mitja1357/Seminar_iz_mehatronike/README.md

# Seminar_iz_mehatronike
Vse kar sem delal pri predmetu seminar iz mehatornike
