mitja1357/Seminar_iz_mehatronike/Porocilo/Alic_seminar_2017.pdf

## UNIVERZA V LJUBLJANI

FAKULTETA ZA ELEKTROTEHNIKO

POROCILO PRI PREDMETU SEMINAR IZ MEHATRONIKE ˇ

# DIGITALNI MERILNIK VRTILNE HITROSTI

## Mitja Aliˇc

Profesor:
prof. dr. Danijel Vonˇcina

Mentor:
doc. dr. Mitja Nemec

Ljubljana, 2017

Mitja Aliˇc | DIGITALNI MERILNIK VRTILNE HITROSTI

## Kazalo

1 Uvod | 2
2 Zahteve | 2
3 Sestava sheme | 3
4 Izdelava tiskanine | 5
5 Programiranje | 5
6 Pisanje poroˇcila | 8
7 Napake projekta | 8
8 Zakljuˇcek | 10
9 Dodatek 1 | 11
10 Dodatek 2 | 14

1

Mitja Aliˇc | DIGITALNI MERILNIK VRTILNE HITROSTI

## 1 Uvod

Pri predmetu seminar iz mehatronike sem si izbral projekt izdelave digitalneg merilnika vrtilne hitrosti. Pri delu na projektu, bom osvojil znanje risanje sheme oži-ˇcenja, risanja tiskanega vezja, izdelava vezja in testiranje. V povezavi s predmetom digitalno procesiranje v mehatroniki 2 (v nadaljevanju DP2), bom napisal program za doloˇcanje vrtilne hitrosti na podlagi poznavanja tenutnega kota zasuka. Cilj izdelanega vezja, je analogni prikaz vrtilne hitrosti na izhodu, katero bi lahko študentje opazovali na laboratorijskih vajah. Podobno seminarsko nalogo je imel Žiga Prajndl¹ leto prej, kjer je uporabil F28069 Piccolo controlSTICK. Piccolo se uporablja pri laboratorijskih vajah predmeta DP2. Na tem ˇcipu naj izdelal salgoritem, nato pa ga prenesel na svojo tiskanino, kjer bi uporabil drug mikrokrmilnik.

## 2 Zahteve

Na zaˇcetku sem si prebral poroˇcilo mojega predhodnika in njegove zahteve prilagodil. Osnovne zahteve so bile enake. Blokovna shema je na sliki 1. Tiskanina bo prikljuˇcena na 5 V napajalni vir. Ostale napetosti so generirane s DC-DC pretvornikom. Za znane komponente sem pregledal podatkovne liste in zaˇcel graditi shemo.

Slika 1: Blokovna shema merilnika z vrednostmi napajalnih napetosti in velikkostjo napetostnih siganlov

Za preraˇcunavanje in komunikacijo sem uporabil mikro krmilni TMS320F28027. Izvorno informacijo o kotu zasuka gredi elektromotorskega sklopa prejemamo iz absolutnega dajalnika zzasuka podjetja RLS z oznako RM44SI0012B30F2E10. Izhod senzorja je lahko inkremantalni z referenˇcno toˇcko, v obliki analognih potekov sinusa in kosinusa, ali preko serijske komunikacije. Komunikacija deluje v diferencialnem naˇcinu, kar poveˇca zanesljivost prenosa. Mikrokrmilnik podpira komunikacijo SPI, zato je potrebno uporabiti gonilik ki pretvori diferencialna signala v polariziran signal. Uporabil sem integrirano vezje SN65HVD73.
Na izhodni strani aplikacije želimo podatek o poziciji in poslediˇcno hitrosti našega pogona pošiljati naprej v analogni obliki za nadaljno regulacijo. Potrebna sta dva analogna izhoda zato sem uporabil TLV5618A. Gre za dvokanalni 12-bitni digitalno analogni pretvornik (DAC). Za višino referenˇcne napetosti Vref sem izbral napetost 4,096 V. Napetost sem generiral s LM4132BMF-4.1.
Tako komunikacija s senzorjem kot tudi z DAC-om zahteva SPI povezavo. Mikrokrmilnik ima le eno SPI enoto. Predhodnik je ugotovil, da lahko senzor in DAC poganja le z eno SPI enoto. Master-input slave-output (MISO) signal služi za prejemanje podatkov s senzorja. Master-output slave-input (MOSI) signal pošlje podatke na DAC. Uro komunikacijskega modula je povezana na obe enoti.

1Digitalni merilnik hitrosti, Žiga Prajndl, LRTME, Ljubljana, 2016

2

Mitja Aliˇc | DIGITALNI MERILNIK VRTILNE HITROSTI

Za zagotovitev željenih izhodnih napetosti izhoda DAC-a ojaˇcam s operacijskim ojaˇcevalnikom. Zahteva mentorja je bila , da ima operacijski ojaˇcevalnik ˇcim manjšo sofazno ojaˇcenje ter naj se vsi nahajajo v enem ohišju. Uporabil sem ojaˇcevaljnik OPA4192IPW. Potreboval sem bipolarno napajanje +/- 15 V, ki sem ga generiral s pretvornikom TMH515D.
Prisotnost napajanja prikazujem na rumeni LED diodi, prikljuˇceni na osnovno napajalno napetost 5 V. Z zeleno LED diodo sem prikazoval trenutno vrednost senzorja. S spreminjanjem pozicija se je spreminjala svetilnost LED diode. To sem izvedel s PWM enoto in tranzistorjem serijsko vezanega s LED diodo. Svetilnost LED diode je tako odvisna od preklopnega razmerja PWM enote. Enako sem storil za rdeˇco led diodo,ki je predstavljala absolutno vrednost hitrosti.

## 3 Sestava sheme

Shemo sem delal v programu Altium Designer 16.1. Celotna shema se nahaja v Dodatek 1.
Mentor mi je poslal svoje starejše projekte, po katerih sem nato povezal pine mikrokrmilnika (Slika 2). Ob njemu je postavljen JTAG konektor. GPIO in PWM pine sem po mikrokrmilniku razporedil tako, da so mi na tiskanini ˇcim bolje ustrezali.


Slika 2: Shema mikrokrmilnika

PWM pina sem povezal s tranzistorjema (Slika 3), kjer nisem povezal upora na maso ("pull-down"). Tako je na gate-u MOS-FET-a lahko ob nepriˇcakovanem dogodku (nedefiniran izhod PWM enote) ostal naboj in poslediˇcno je LED dioda svetila.
Pri povezavi pretvornika komunikacije je predhodnik naredil lapsus (zamenjal para ure in podatka na SN65HVD73). To sem zamenjal, nisem pa zamenjal tudi elemntov. Med izhodom senzorja zasuka mora biti paralelno vezan 120 Ω upor in manjši kondenzator. To pa sem obdržal med povezavama +CLK -CLK. Tekom projekta sem ugotovil, da je to napaka. Upor R10 in kondenzator C12 (Slika 4), bi se morala nahajati med +DAT in -DAT. Upora R11 in R12 bi morala biti na povezavi +CLK oz - CLK.

3

Mitja Aliˇc | DIGITALNI MERILNIK VRTILNE HITROSTI


Slika 3: Shema krmiljenja LED diod

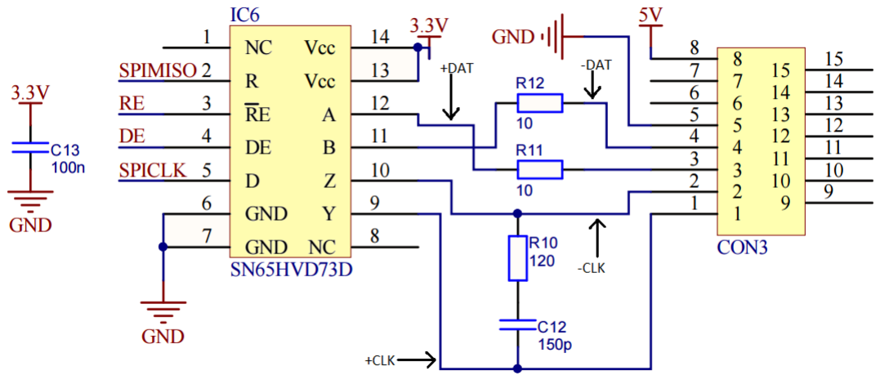
[picture p14: figure]

Slika 4: Shema komunikacije s senzorjem zasuka

Vezava DAC-a je na sliki 5. Takoj na sliki se vidi, da sem pine oznaˇceval na levi strani od zgoraj navzol in na desni prav tako. Ob izbiri "footprint-ašem upošteval razvršˇcenost pinov na levi od zgoraj navzol na desni pa od spodaj navzgor. Tako je bil "footprint"leve strani DAC-a v obratnem vrsnem redu. Huda napaka je predvsem to, da je masa DAC-a vezna na 5 V. Pini, vezani z ostalo periferijo lahko tako deformirajo druge dele vezja.


Slika 5: Shema DAC-a

Operacijske ojaˇcevalnike bi moral le prerisati, ojaˇcenje pa zmanjšati za polovico. Sam sem sestavil le blok kot skupek 4 ojaˇcevalnikov. Ob povezovanju sem naredil napako, da sem na ojaˇcevalniku C zamenjal vhoda. Tako sem naredil pozitivno po-

4

Mitja Aliˇc | DIGITALNI MERILNIK VRTILNE HITROSTI

vratno zanko in poslediˇcno vezje ni ustrezalo odštevalniku (Slika 6).


Slika 6: Shema operacijskega ojaˇcevalnika

## 4 Izdelava tiskanine

Ko sem shemo, po mojem mnenju zakljuˇcil, sem se lotil postavitve elementov na dvoplastno tiskanino. Rezultat je na sliki 7.
"Footprint-e" sem nastavil že na shemi, zato se s tem tu nisem ukvarjal. Vse napake na tiskanini, so posledica nenatanˇcnosti pri naˇcrtovanju sheme. Konektor za napajanje sem izbral tako, da je bilo potrebno vanj vijaˇciti napajalni žici. Naslednik naj uporabi konektor, katerega lahko izklopi brez kakšnih potrebnih pripomoˇckov. Sam sem postavil na tiskanino upore in kondenzatorje velikosti 0603²
. V laboratoriju
LRTME ponavadi uporabljajo komponente velikosti 0805, zato jih je bilo potrebno na Farnell-u naroˇciti. Najprej sem s pomoˇcjo Aleksandra Abramoviˇca naspajkal mikrokrmilnik, nato pa nadeljeval z upori ter kondenzatorji okoli mikrokrmilnika. Naspajkal sem vse razen napajalnika za napetost ±15V in DAC-a. DAC-a ob naroˇcanju materiala na Farnell-u ni bilo veˇc na zalogi, zato sem ga naroˇcil na Mouser-ju. Ko sem prviˇc priklopil vezje na napetostni vir, sem napajalno napetost poˇcasi višal in opazoval vhodni tok. Še preden sem zaˇcel vezje programirati sem prevezal pina na ojaˇcevalniku C, katera sem v shemi zamenjal. Preko Texas Instruments XDS100v2 USB Debug Probe sem priklopil vezje na raˇcunalnik in lahko zaˇcel programirati v Code Composer Studio.

## 5 Programiranje

Programirati sem zaˇcel v koncu februarja 2017. Projekt z zaˇcetnimi header datotekami, osnovnimi inicializacijami mikrokrmilnika in prekinitvijo mi je pripravil mentor. Potek programirannja sem si zadal po naslednjem seznamu:

2
Imperialne enote, v metriˇcnem sistemu je to 1608

5

Mitja Aliˇc | DIGITALNI MERILNIK VRTILNE HITROSTI

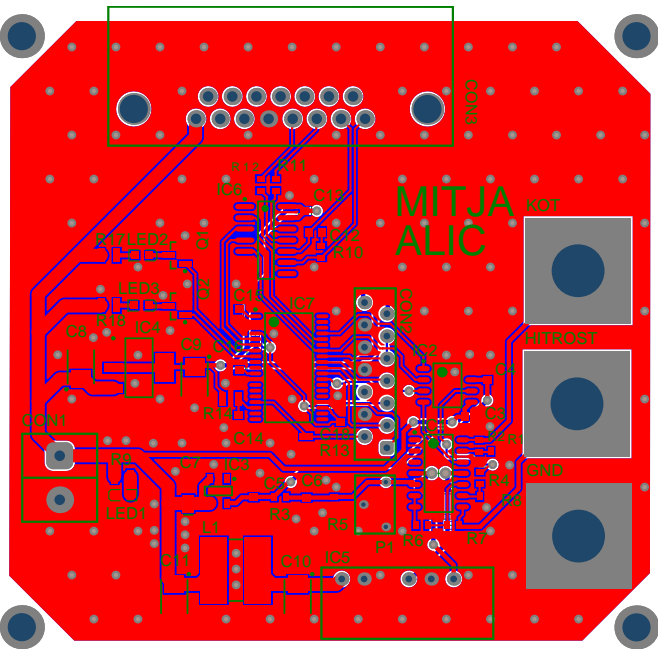
[picture p15: figure]
LED2; LED1; CON1; LED3; GND; HITROST; KOT; MITJA ALIC

Slika 7: Izgled tiskanine katera je šla v izdelavo

- Zaženi PWM enoto za krmiljenje LED diod
- Uredi komunikacijo s senzorjem zasuka
- Dodaj algoritem alfa beta filtra za izraˇcun hitrosti
- Uredi komunikacijo z DAC-om

### 5.1 PWM enota

Za PWM enoti sem moral pina GPIO 4 in GPIO 5 nastaviti za PWM izhoda. Nastavil sem registre tretjega modula PWM, kateremu pripadata izhodna pina. Ob reset-u programa sta prikazovalni LED diodi prikazovali nakljuˇcna stanja saj se je izhod PWM enote postavil v visoko impedanˇcno stanje, pull-down upora na gate-u tranzistorja pa ni bilo.

### 5.2 Povezava s senzorjem zasuka

Pri predmetu DP2 sem dobil že napisano inicializacijo in zajem kota po SPI komunikaciji. Potrebni datoteki (SPI_ dajalnik.h in SPI_ dajalnik.c) sem dodal v projekt. Nastaviti sem moral še pina za krmiljenje ˇcipa za spremembo komunikacije (DE na GPIO 2 in RE na GPIO 3). Nastavil sem ju na vrednosti tako, da je bila komunikacija ves ˇcas mogoˇca. Ko sem želel preveriti delovanje se je hitro pokazalo nedelovanje. Za vrnjen podatek sem dobil le invertiran urin signal. To je bila posledica moškega "footprint-a" konektorja za povezavo s senzorjem. Zaradi zrcaljne slike je bila žica

6

Mitja Aliˇc | DIGITALNI MERILNIK VRTILNE HITROSTI

katera napaja senzor vezana na pin CLK+. Senzor se je s tem signalom le prižigal in ugašal. To napako sem rešil tako, da sem konektor odstranil z zgornje strani tiskanine in ga prispajkal na spodnjo stran. S tem posegom sem izhodne pine konektorja spravil na pravo mesto in komunikacija je delovala.

### 5.3 Algoritem za izraˇcun hitrosti

Kodo za izraˇcun vrtilne hitrosti sem napisal že pri vajah predmeta DP2. Vrnjen rezultat je bila frekvenca in ne vrtilna hitrost, ki je le za faktor 2π skalirana. V programu sem raˇcunal s plavajoˇco vejico (na procesorju TMS320f28069). Ko sem dodal to kodo v moj mikrokrmilnik, se kode ni uspela izvajati dovolj hitro. Alogritem sem zato pretvoril na raˇcunaje s fiksno vejico³
. Algoritem se nahaja v Dodatek 2. Uporabil sem knjižnico IQ_ math. Algoritem se tako izvede v dovolj kratkem ˇcasu, ˇcasa pa nisem pomeril.

### 5.4 Povezava z digitalno analognim pretvornikom

Ko sem dobil DAC in je bil algoritem za izraˇcun hitrosti dokonˇcan, sem naspajkal pretvornik na tiskanino. Ob prikljuˇcitvi na napetostni vir, tiskanina ni izkazovala nobene napake. Zato sem se lotil nastavljanja izhodov za postavitev komunikacije. Za vzpostavitev komunikacije (chip enable), sem uporabil GPIO 34, kateri ima le to funkcijo. V "datasheet-u" nikjer drugje ni bil niˇc opisan. Vsi ostali pini imajo veˇc funkcij, zato je bil vsak pin podrobneje opisan, GPIO 34 pa ima le to funkcijo in ne potrebuje drugega opisa. Ko bi moral postaviti GPIO 34 na 0 V je imel ta konstntno 5 V. Naj omenim, da je mikrokrmilnik napajan s 3,3 V in v razponu, od 0 V do napajalne napetosti, je lahko izhod. To se mi tu še ni posvetilo. Dvomil sem v pin GPIO 34 kateri ni bil podrobneje opisan v "datasheet-u". Zato sem na mikrokrmilniku prevezal tako, da sem chip enable pin DAC-a povezal z GPIO 19. Ta pin ima že funkicjijo, da se postavi v želejeno stanje ob zaˇcetku SPI komuniciranja. Vendar ta prevezava ni pomagala. Mentor je nato ugotovil napako, ki je bila ustvarjena v shemi, da so pini DAC-a na levi strani zamenjani. Na tej toˇcki je mentor predlagal, da s projektom konˇcam in bo zapisan kot neuspešno izdelan. Nato sva ugotovila, da se lahko DAC še preveže v delujoˇce stanje.
Prevezal sem DAC in zaˇcelo je delovati. Po tem je bilo potrebno samo še skalirati in nastaviti vrednosti, da bo konˇcni izhod napetosti hitrosti in kota med ± 10V. Pojavila se je težava, da je izhod B DAC-a upadel za približno 1 V ko je potekala komunikacija. Tega nisem znal rešiti, slutim pa, da je bila napaka povzroˇcena z dodatnimi prevezavami na tiskanini.

### 5.5 Ostale težave

Nepravilno se je zaˇcel obnašati tudi komunikacija s senzorjem zasuka. Kljub temu, da je senzor prejemal urin signal, ni vraˇcal podatka. Podatek je vrnil ˇce sem ob pravem trenutku spremenil vednost DE pina na komunikaciji iz 0 na 1. To sem ugotovil, ko sem ponesreˇci povezal pin DE s pinom SPICLK. Vrednost na pinu DE je tako prekapljala med 0 in 1 in komunikacija je nato zaˇcela delovati. To sem poskušal nato doseˇci tudi s programom, tako da je preklapljal vrednost na pinu DE vendar se ni odzval vedno.

3Uporabil sem format f8.24

7

Mitja Aliˇc | DIGITALNI MERILNIK VRTILNE HITROSTI


Slika 8: Tiskanina na koncu projekta

Po tednu iskanja rešitve za nastale težave sem se odloˇcil in mentorju sporoˇcil, da bi projekt raje zakljuˇcil saj traja že predolgo. Projekt ni bil tako kompleksen, vendar sem si ga z napakami zakompliciral sam.

## 6 Pisanje poroˇcila

V poroˇcilu sem morala zbrati vse napake, ki sem jih naredil pri projektu. Hotel sem posneti oscilograme vendar sem ob tem skuril mikrokrmilnik. Zato oscilogramov v tem poroˇcilu ne boste opazili.

## 7 Napake projekta

### 7.1 Moški "footprint" za ženski konektor

Mentor me je velikokrat opozoril ali sem resniˇcno uporabil pravi "footprint" za konektor, vendar tega ob sestavljanju sheme nisem nikoli preveril. Napaka se je pokazala ob vzpostavljanju komunikacije s senzorjem. Napako sem rešil tako, da sem konektor prispajkal s spodnje strani tiskanine( slika 9).

### 7.2 Prikljuˇcek za napajanje

Ta napaka niti ni tako huda, je pa priporoˇcljivo da se uporabi konektor katerega lahko odklopiš, brez izvijaˇca. Konektor katerega sem uporabil se vidi na desni strani slike 9.

8

Mitja Aliˇc | DIGITALNI MERILNIK VRTILNE HITROSTI


Slika 9: Konektor prispajkan na spodnji strani tiskanine zaradi anpake v "footprintu"

### 7.3 Pull-down upori na gate-u MOS-FETa

Pin mikrokrmilnika je bil direktno vezan na gate tranzistorja. Ob prikljuˇcitvi napajalne napetosti so izhodi mikrokrmilnika v visoko impedanˇcnem stanju. Tranzistor je v tem stanju lahko prevajal, lahko ne. To bi rešil upor vezan na maso in tako definiral stanje v primeru visoko impedanˇcnega stanja pina na mikrokrmilniku. Prajndl je upore uporabil, jaz sem jih spustil.

### 7.4 Napaka v povezavi senzorja z vezjem

V poglavju 3, sem že opisal zamenjavo impedanc med paroma ure (CLK) in podatka (DAT). To napako sem našel na koncu, ko mi komunikacija s senzorjem ni delovala in sem se posvetil branju "datasheet-a" senzorja RM44SI. Opazil sem, da je potrebno pri izhodnih signalih senzorja vezati 120Ω upor in kondenzator, kar sem popravil. Še ena napaka, ki me je nauˇcila naj dobro berem vse podatkovne listine.

### 7.5 Postavitev potenciometra poleg JTAG konektorja

Na sliki 8, prav tako na sliki 9 se vidi da potenciometer ni lepo prispajkan. Razlog je v tem, ker sem ga na tiskanini postavil preblizu konektorja JTAG. Ko sem želel povezati tiskanino z raˇcunalnikom, ni bilo prostora za nasaditev prikljuˇcka. Potenciometer sem moral tako zamakniti, da sem lahko uporabil konektor. Ob konˇcnem izdelku to niti ni napaka, saj konektor služi le za povezavo z raˇcunalnikom v ˇcasu razvijanja programa. Ja pa to šola za naprej, da si ob konektorjih pustim dovolj prostora. Napaka pa je bila popolnoma nepotrebna, ˇce bi bil dosleden.

9

Mitja Aliˇc | DIGITALNI MERILNIK VRTILNE HITROSTI

### 7.6 Zamenjana vhoda na odštevalniku

Napaka, ki bi jo moral hitro opazi že na shemi. Povezavi na vhodu ojaˇcevalnika C sem obrnil. S tem sem naredil pozitivno povratno zanko. To se je dalo popraviti s prevezavo na tiskanini.

### 7.7 Narobe konfigurirani pini na DAC-u

Na DAC-u sem levi strani pinov pripisal napaˇcne "designatorje". Na levi strani sem jih oštevilˇcil od zgoraj navzol. Na "footprint-u"pa oštevilˇcenje pinov na levi strani, poteka od spodaj navzgor. To napako bi lahko popravil ˇce bi spremenil oznake "designatorjev", ali še lažje v nastavitvah Pin Map bi lahko posameznemu pinu na shemi priredil pin na "footprint-u".

### 7.8 Napaˇcna vrednost referenˇcne napetosti

Ob koncu projekta sem ugotovil, da moja referenˇcna napetost (4,096 V), ni bila najprimernejša. V "datasheet-u"DAC-a sem opazil kasneje, da je najprimerneje uporabiti vrednost referenˇcne napetosti 2,048V. Najvišja refernˇcna napetost pa naj nebi bila višja od VDD -1,5 V. Ni kljuˇcna napaka je pa prav, da jo omenim.

## 8 Zakljuˇcek

V projektu sem ustvaril lepo zbirko napak. Veˇc ali manj jih je bilo proizvedenih med izdelavo sheme, katere sem se lotil zelo lahkotno. Ta lahkotna misel pri sestavi sheme, me je pripeljala do neuspešnega zakljuˇcka. S tem projektom sem se po mojem mnenju na nekoliko boleˇc naˇcin npridobil dosti veˇc novega znanja in bom zato v prihodnosti bolj dosleden.

10

## 9 Dodatek 1

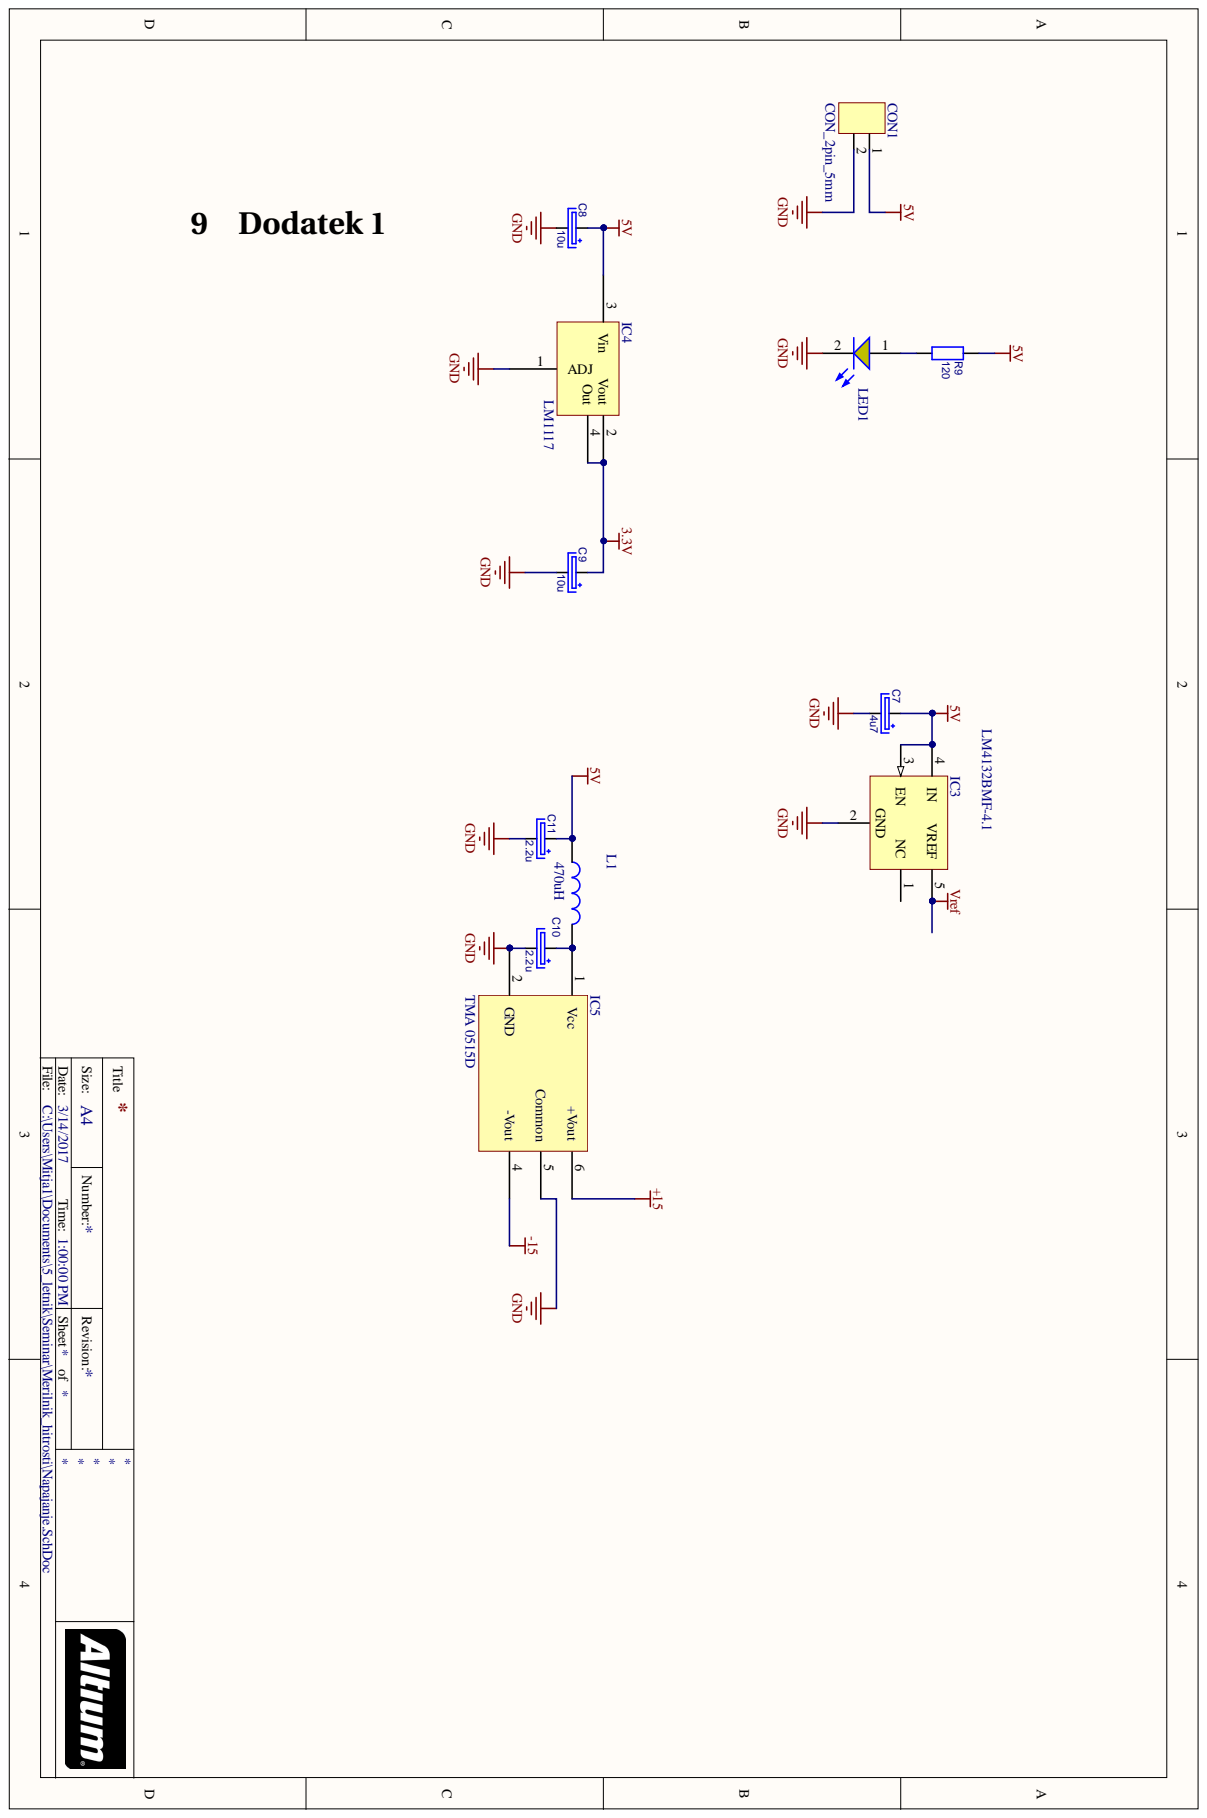
[picture p16: page 12]

C:\Users\Mitja1\Documents\5_letnik\Seminar\Merilnik_hitrosti\Napajanje.SchDoc

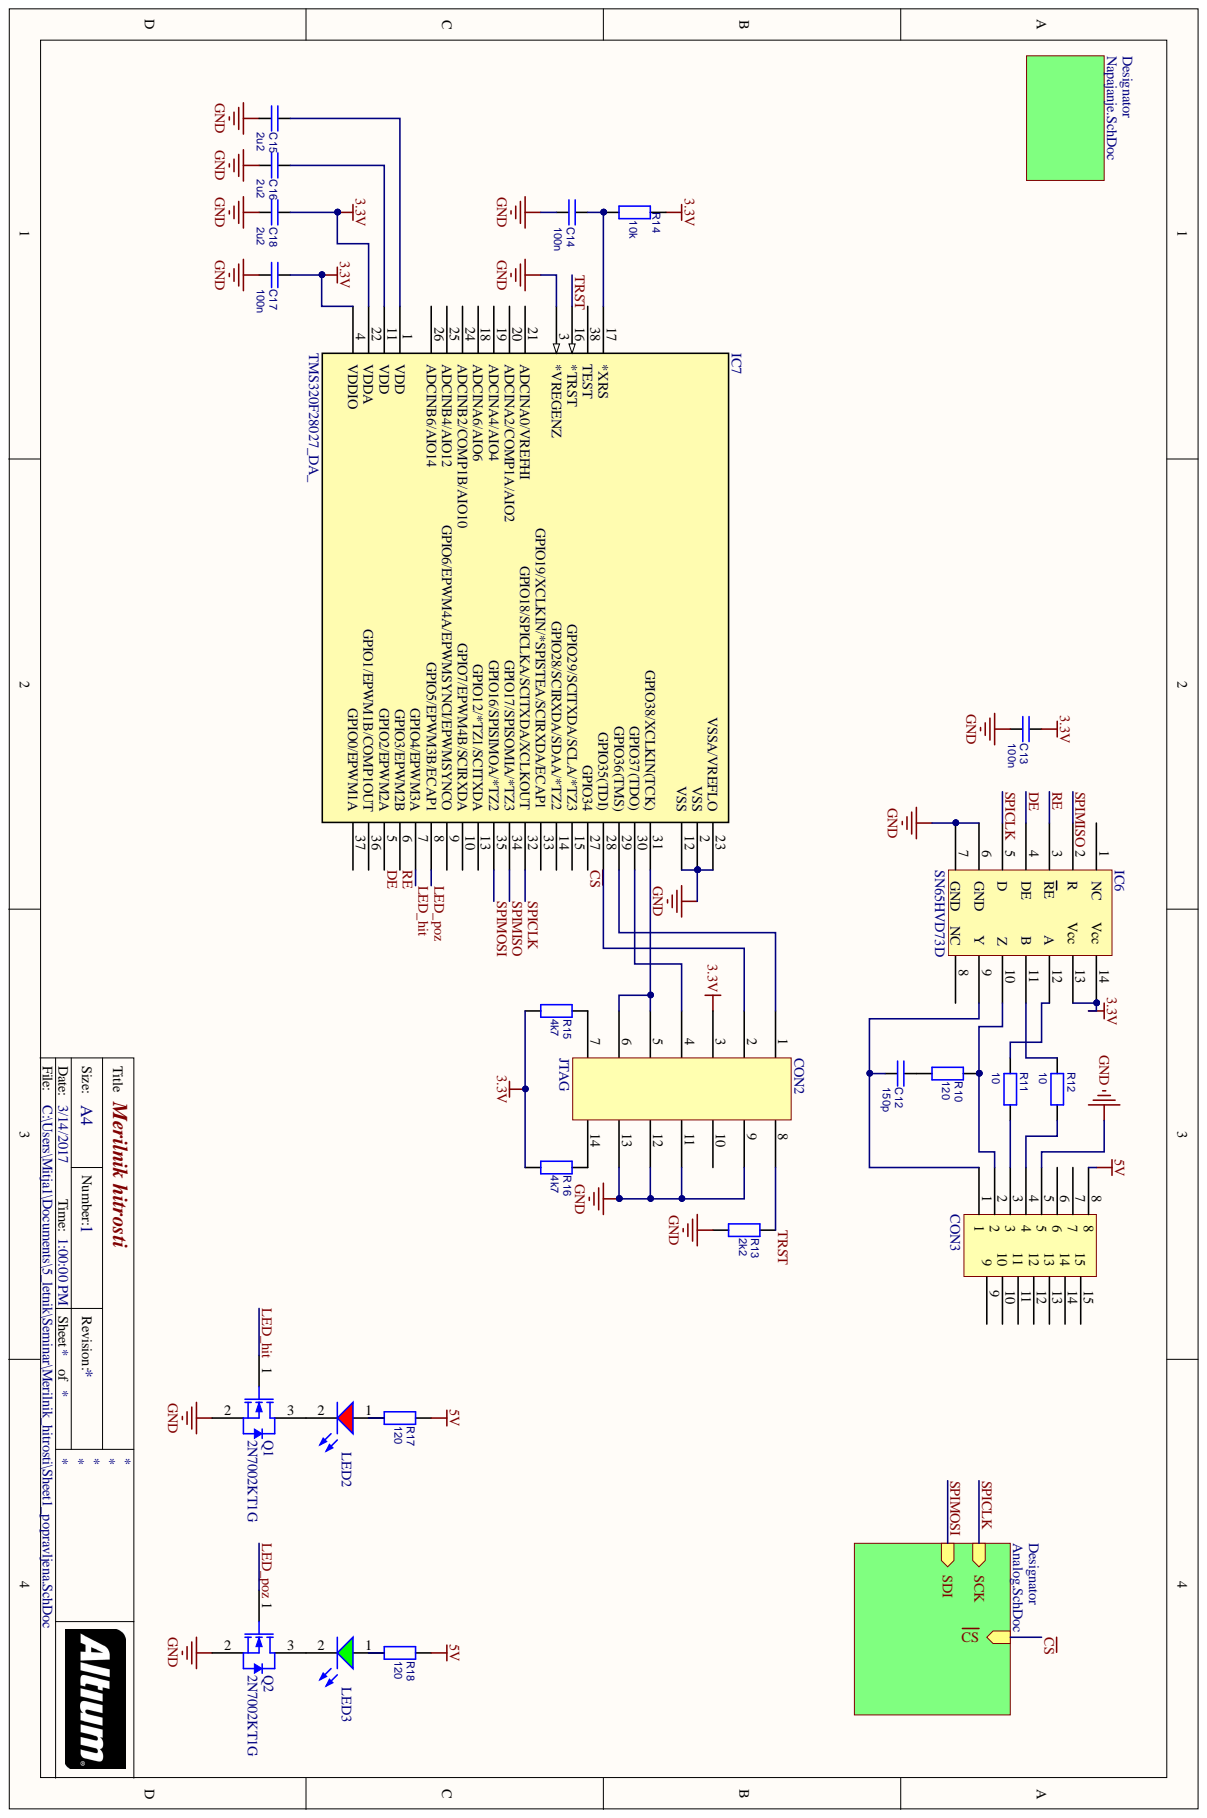
[picture p17: page 13]

VDDIO 4 GPIO0/EPWM1A 37 GPIO1/EPWM1B/COMP1OUT 36 GPIO2/EPWM2A 5 GPIO3/EPWM2B 6 GPIO4/EPWM3A 7 GPIO5/EPWM3B/ECAP1 8 GPIO6/EPWM4A/EPWMSYNCI/EPWMSYNCO 9 GPIO7/EPWM4B/SCIRXDA 10 GPIO12/*TZ1/SCITXDA 13 GPIO16/SPISIMOA/*TZ2 35 GPIO17/SPISOMIA/*TZ3 34 GPIO18/SPICLKA/SCITXDA/XCLKOUT 32 GPIO19/XCLKIN/*SPISTEA/SCIRXDA/ECAP1 33 GPIO28/SCIRXDA/SDAA/*TZ2 14 GPIO29/SCITXDA/SCLA/*TZ3 15 GPIO34 27 GPIO35(TDI) 28 GPIO36(TMS) 29 GPIO37(TDO) 30 GPIO38/XCLKIN(TCK) 31

VSS 12 VSS 2 VSSA/VREFLO 23

C:\Users\Mitja1\Documents\5_letnik\Seminar\Merilnik_hitrosti\Sheet1_popravljena.SchDoc

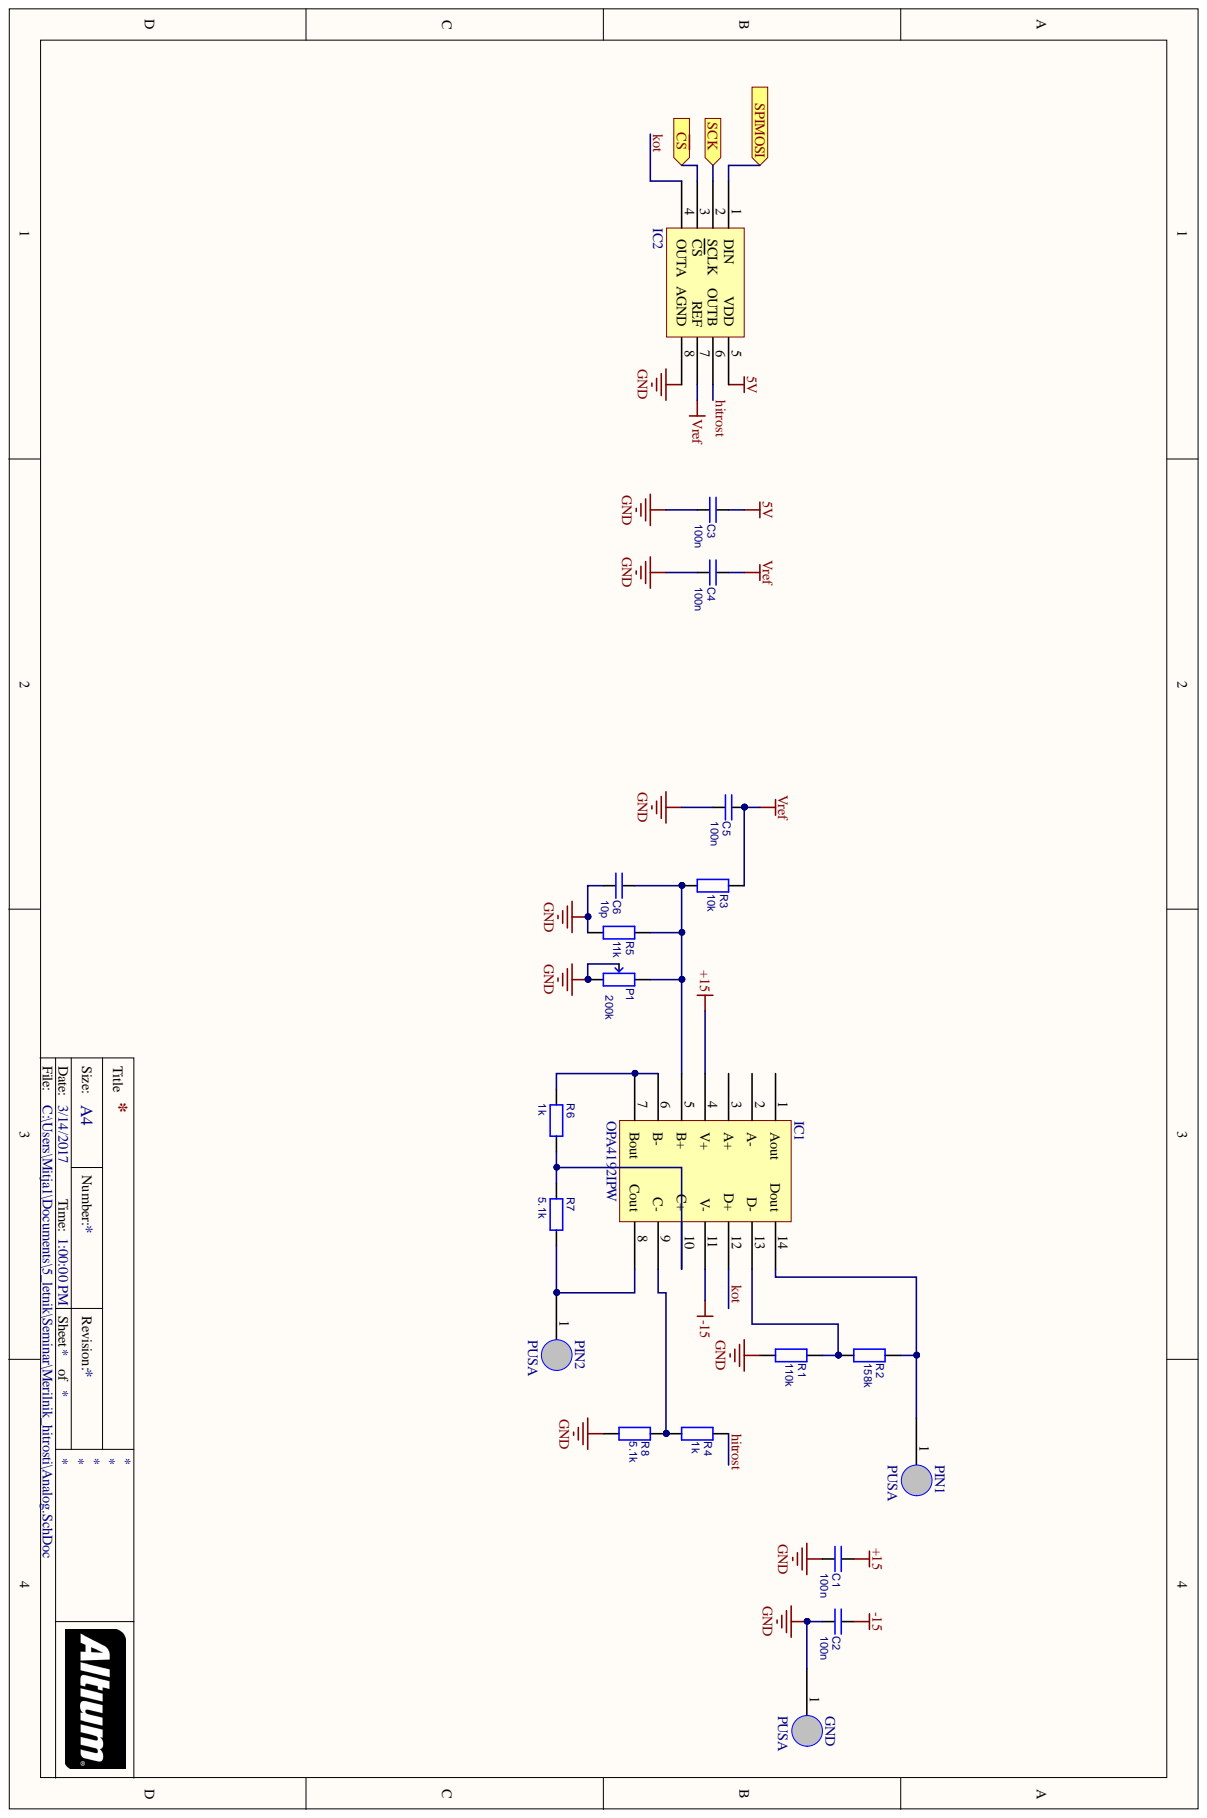
[picture p18: page 14]

C:\Users\Mitja1\Documents\5_letnik\Seminar\Merilnik_hitrosti\Analog.SchDoc

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
