mitja1357/Seminar_iz_mehatronike/Merilnik_hitrosti/shema.pdf

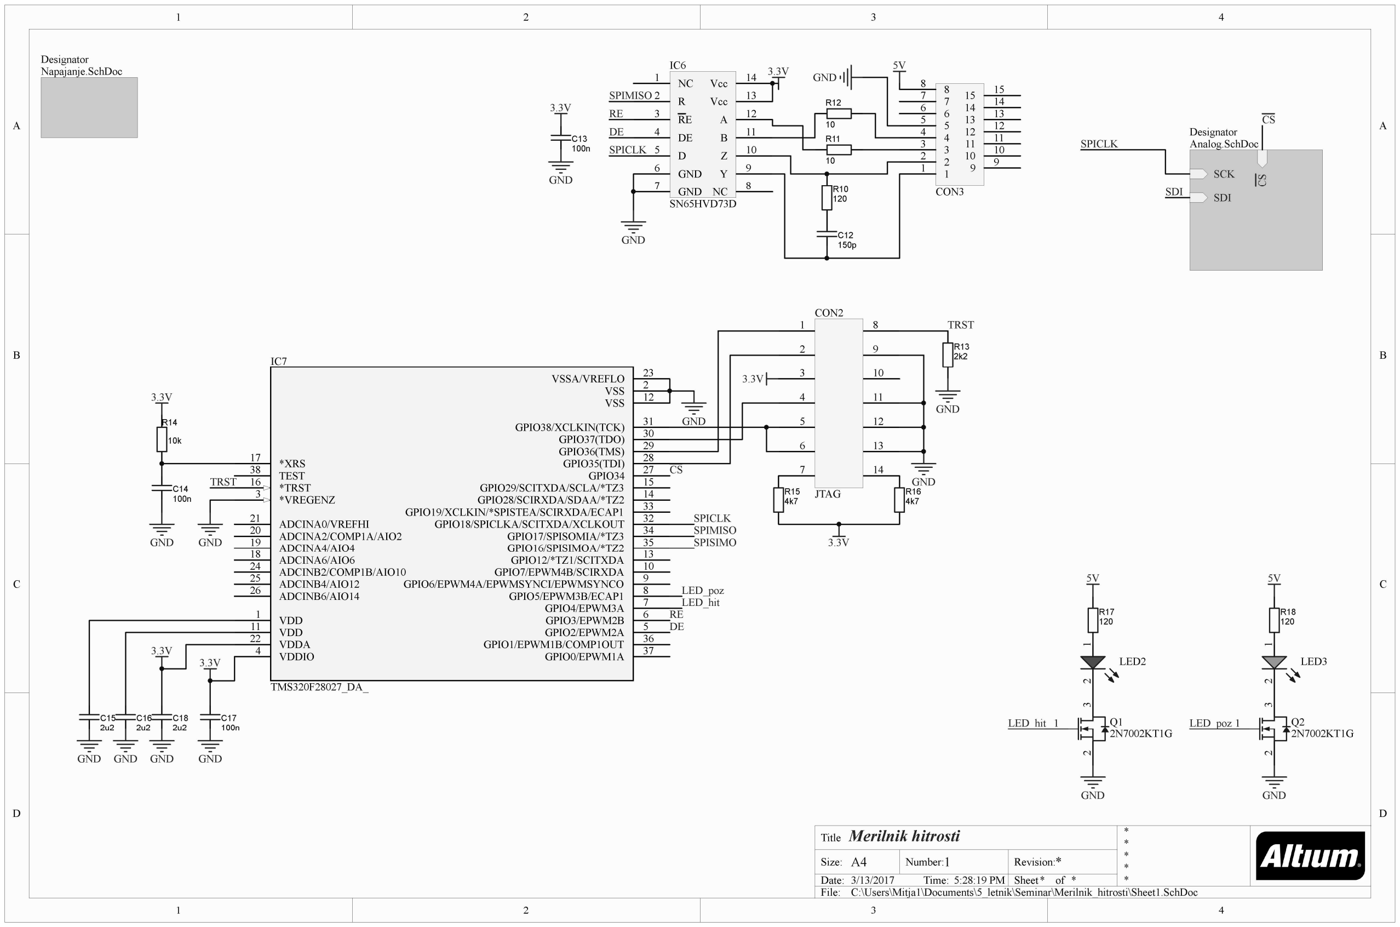
[picture p19: page 1]

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
* | *

## Merilnik hitrosti

1 *
3/13/2017 | 5:28:19 PM
C:\Users\Mitja1\Documents\5_letnik\Seminar\Merilnik_hitrosti\Sheet1.SchDoc

Title

Size: | Number:
Date:
File:

Revision:
Time: | Sheet | of

A4

*XRS 17
TEST 38
*TRST 16
*VREGENZ 3

ADCINA0/VREFHI 21
ADCINA2/COMP1A/AIO2 20
ADCINA4/AIO4 19
ADCINA6/AIO6 18
ADCINB2/COMP1B/AIO10 24
ADCINB4/AIO12 25
ADCINB6/AIO14 26

VDD 1
VDD 11
VDDA 22
VDDIO 4 | GPIO0/EPWM1A | 37 GPIO1/EPWM1B/COMP1OUT | 36 GPIO2/EPWM2A | 5
| GPIO3/EPWM2B | | | 6
GPIO4/EPWM3A | 7
GPIO5/EPWM3B/ECAP1 | 8
GPIO6/EPWM4A/EPWMSYNCI/EPWMSYNCO | 9
GPIO7/EPWM4B/SCIRXDA | 10 GPIO12/*TZ1/SCITXDA | 13 GPIO16/SPISIMOA/*TZ2 | 35 GPIO17/SPISOMIA/*TZ3 | 34 GPIO18/SPICLKA/SCITXDA/XCLKOUT | 32 GPIO19/XCLKIN/*SPISTEA/SCIRXDA/ECAP1 | 33 GPIO28/SCIRXDA/SDAA/*TZ2 | 14 GPIO29/SCITXDA/SCLA/*TZ3 | 15 GPIO34 | 27 GPIO35(TDI) | 28 GPIO36(TMS) | 29 GPIO37(TDO) | 30 GPIO38/XCLKIN(TCK) | 31
VSS | 12 VSS | 2
VSSA/VREFLO | 23

IC7

TMS320F28027_DA_ | 1 2

LED3 ¹ 2
LED2

Designator
Napajanje.SchDoc

120

R18
120

R17

5V | 5V
GND | GND

SCK
SDI CS

Designator
Analog.SchDoc

GND

3.3V

3.3V

2k2

R13

GND

SPICLK
SPIMISO

SPICLK

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
10 | 10 11 | 11 12 | 12 13 | 13 14 | 14 15 | 15

CON3

5V
GND

10

R12
RE

LED_poz

DE

RE

LED_hit

LED_hit | LED_poz

100n

C13

GND

3.3V

4k7

R15
4k7

R16

GND

GND

100n

C17

3.3V

GND

2u2

C18

GND

2u2

C16

GND GND

2u2

C15

100n

C14

GND

3.3V

10k

R14

3.3V | 3

1 2

Q1

2N7002KT1G | 3 1 2
Q2
2N7002KT1G

TRST

### 1 TRST

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
CON2

JTAG

CS

CS

SPISIMO

SDI

NC 1

R

2
RE 3
DE 4

D

5
GND 6
GND 7 | NC | 8

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
Vcc | 13
Vcc | 14

IC6

SN65HVD73D

10

R11

150p

C12

120

R10

SPICLK

SPIMISO

DE

3.3V

GND
