mitja1357/Seminar_iz_mehatronike/Merilnik_hitrosti/shema_img0.png

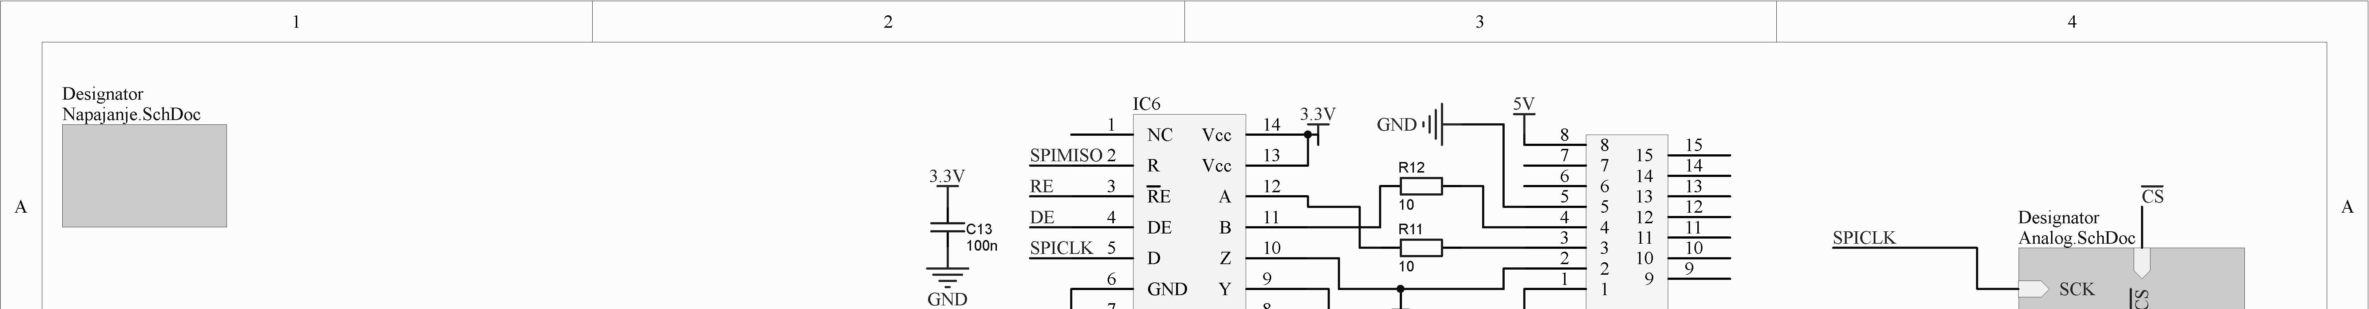
Merilnik_hitrosti/shema_img0.png
