mitja1357/Seminar_iz_mehatronike/Merilnik_hitrosti/shema_img2.png

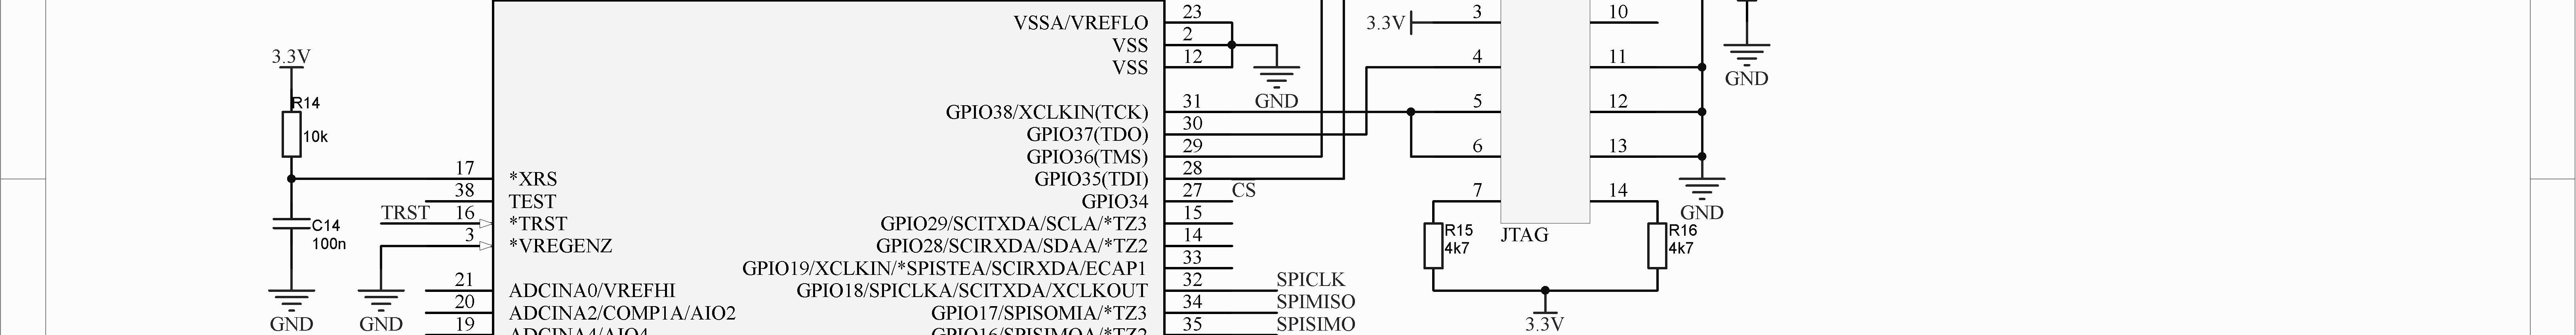
Merilnik_hitrosti/shema_img2.png
