mitja1357/Seminar_iz_mehatronike/Merilnik_hitrosti/Merilnik_hitrosti.xlsx

Comment | Description | Designator | Footprint | Quantity | Supplier 1 | Supplier Part Number 1
100n | Capacitor | C1, C2, C3, C4, C5, C13, C14, C17 | C0603 | 8
10p | Capacitor | C6 | C0603 | 1
4u7 | Capacitor Polarized | C7 | C Tantal A | 1
10u | Capacitor Polarized | C8, C9 | C Tantal B | 2
2.2u | Capacitor Polarized | C10, C11 | C Tantal B | 2
150p | Capacitor | C12 | C0603 | 1
2u2 | Capacitor | C15, C16, C18 | C0603 | 3
CON_2pin_5mm | Konektor za Bernic ohišja Serija 605, 5 mm raster | CON1 | CON_2pin_5mm | 1 | Farnell | 1792766 (https://octopart-clicks.com/click/altium?manufacturer=PHOENIX%20CONTACT&mpn=MKDSN2,5%2F2-5.08&seller=Farnell&sku=1792766&country=US&channel=BOM%20Report)
JTAG |  | CON2 | JTAG micromatch | 1 | Farnell | 148647 (https://octopart-clicks.com/click/altium?sku=148647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)
DSUbConector |  | CON3 | DSUB conector | 1 | Farnell | 1099295 (https://octopart-clicks.com/click/altium?sku=1099295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)
OPA4192IPW onepack |  | IC1 | OPA4192 | 1 | Farnell | 2526481 (https://octopart-clicks.com/click/altium?sku=2526481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)
TLV5618ACD |  | IC2 | TLV5618ACD | 1 | Farnell | 2342319 (https://octopart-clicks.com/click/altium?sku=2342319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)
LM4132BMF-4.1 | Precision Low Dropout Voltage Reference, 5-pin SOT-23 | IC3 | SOT95P280X145-5N | 1 | Farnell | 1559272 (https://octopart-clicks.com/click/altium?sku=1559272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)
LM1117 |  | IC4 | SOT230P700X180-4N | 1 | Farnell | 1469051 (https://octopart-clicks.com/click/altium?sku=1469051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)
TMA 0515D |  | IC5 | TMA 0515D | 1 | Farnell | 1007516 (https://octopart-clicks.com/click/altium?sku=1007516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)
SN65HVD73D | High Output Full-Duplex RS-485 Driver and Receiver, 1 Mbps, 5 V, -40 to 85 degC, 14-pin SOIC (D), Green (RoHS & no Sb/Br) | IC6 | D14_N | 1 | Farnell | 2455484 (https://octopart-clicks.com/click/altium?sku=2455484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)
TMS320F28027_DA_ | Imported | IC7 | TSOP65P810X120-38N | 1 | Farnell | 2076786 (https://octopart-clicks.com/click/altium?sku=2076786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)
WE-PD2, 74477530 | WE-PD2 SMD Power Inductor, size 7850, 1000uH | L1 | WE-PD2_7850 | 1 | Farnell | 2062739 (https://octopart-clicks.com/click/altium?sku=2062739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)
150060YS75000 | SMD mono-color Chip LED, WL-SMCW, Yellow | LED1 | LED_0603_Yellow | 1 | Farnell | 2322074 (https://octopart-clicks.com/click/altium?sku=2322074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)
150060RS75000 | SMD mono-color Chip LED, WL-SMCW, Red | LED2 | LED_0603_Red | 1 | Farnell | 2322071 (https://octopart-clicks.com/click/altium?sku=2322071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)
150060VS75000 | SMD mono-color Chip LED, WL-SMCW, Bright Green | LED3 | LED_0603_Bright Green | 1 | Farnell | 2322073 (https://octopart-clicks.com/click/altium?sku=2322073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)
200k | POTENTIOMETER | P1 | Bourns_3266W | 1 | Farnell | 9352651 (https://octopart-clicks.com/click/altium?sku=9352651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)
2N7002KT1G | N-Channel Enhancement Mode Field-Effect Transistor, 50 V, 0.173 A, 3-Pin SOT23, Tape and Reel | Q1, Q2 | NXP-SOT23_N | 2 | Farnell | 1764535 (https://octopart-clicks.com/click/altium?sku=1764535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)
110k | R | R1 | R0603 | 1
158k | R | R2 | R0603 | 1
10k | R | R3 | R0603 | 1
1k | R | R4, R6 | R0603 | 2
11k | R | R5 | R0603 | 1
4.87k | R | R7, R8 | R0603 | 2
120 | R | R9, R13, R14, R17, R18 | R0805 | 5 | Farnell | 9332596 (https://octopart-clicks.com/click/altium?sku=9332596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)
120 | R | R10 | R0603 | 1
10 | R | R11, R12 | R0603 | 2
4k7 | R | R15, R16 | R0805 | 2
