mitja1357/Seminar_iz_mehatronike/Merilnik_hitrosti/Merilnik_hitrosti.pdf

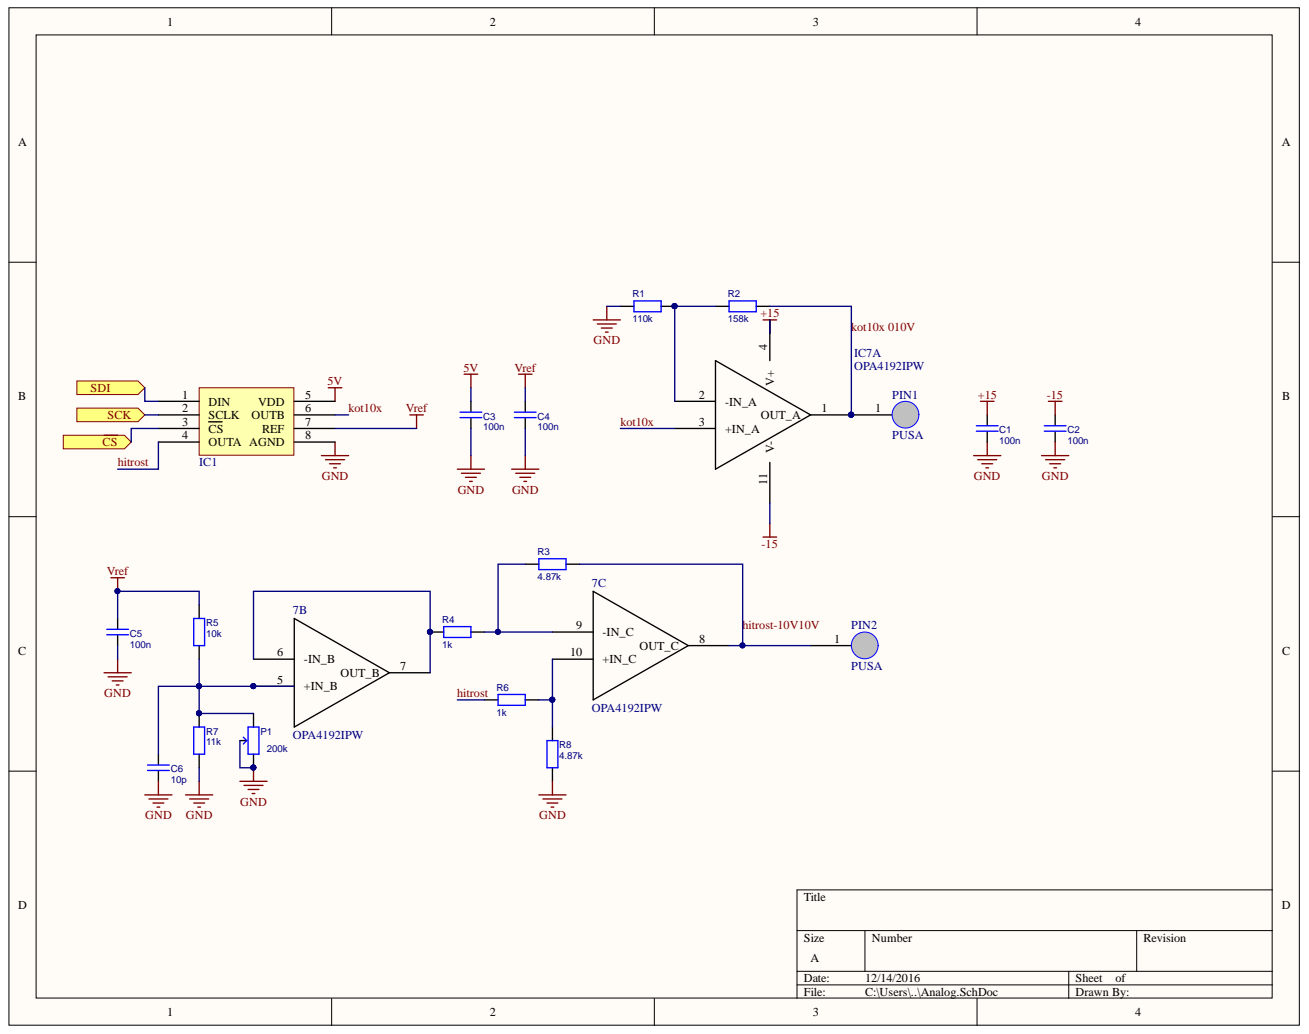
[picture p25: page 1]

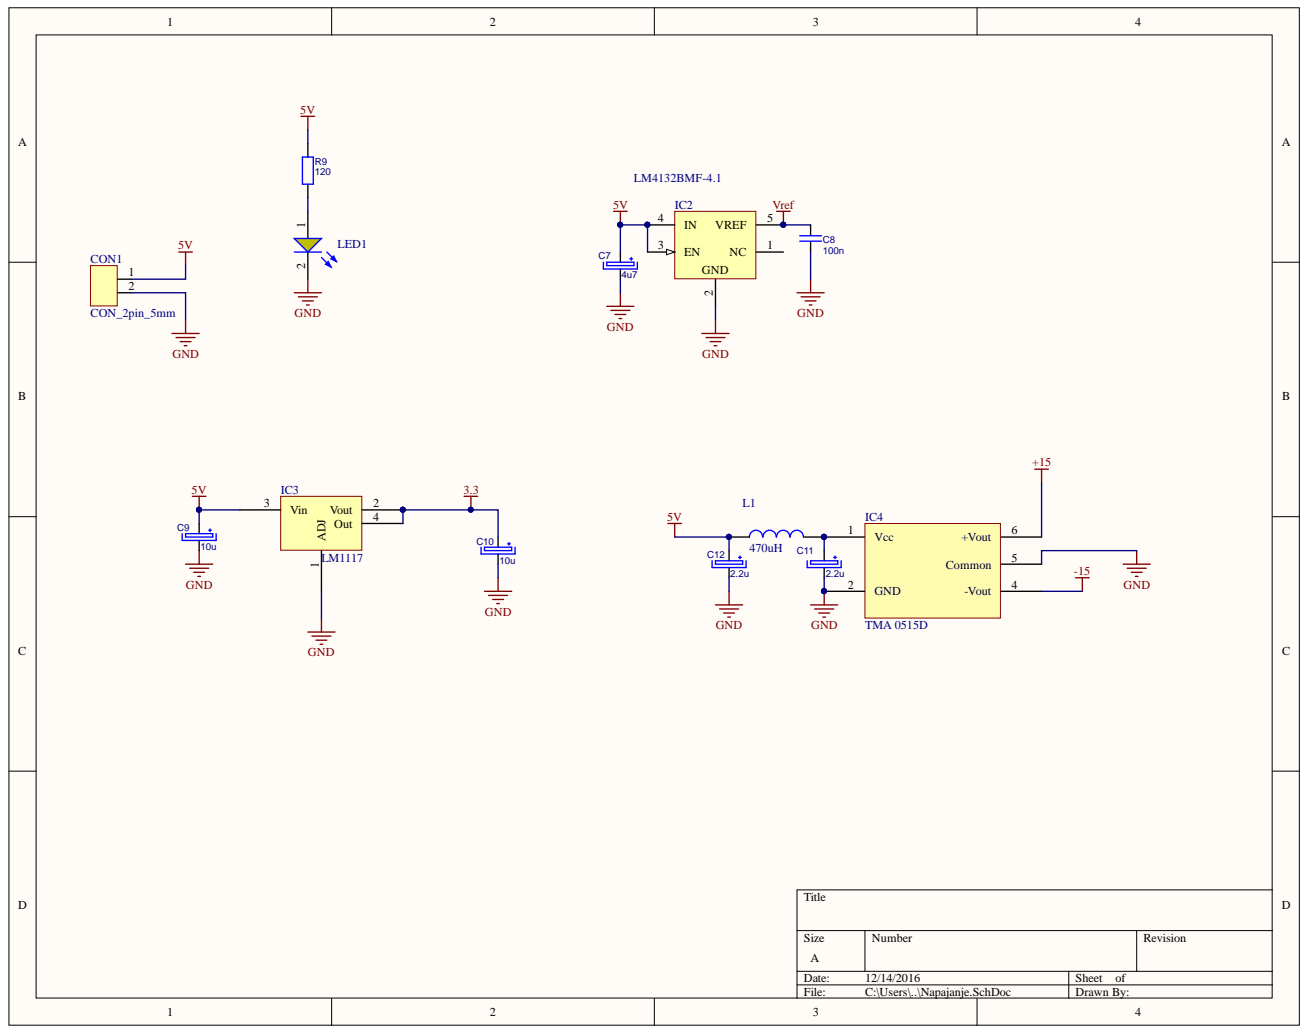
[picture p26: page 2]

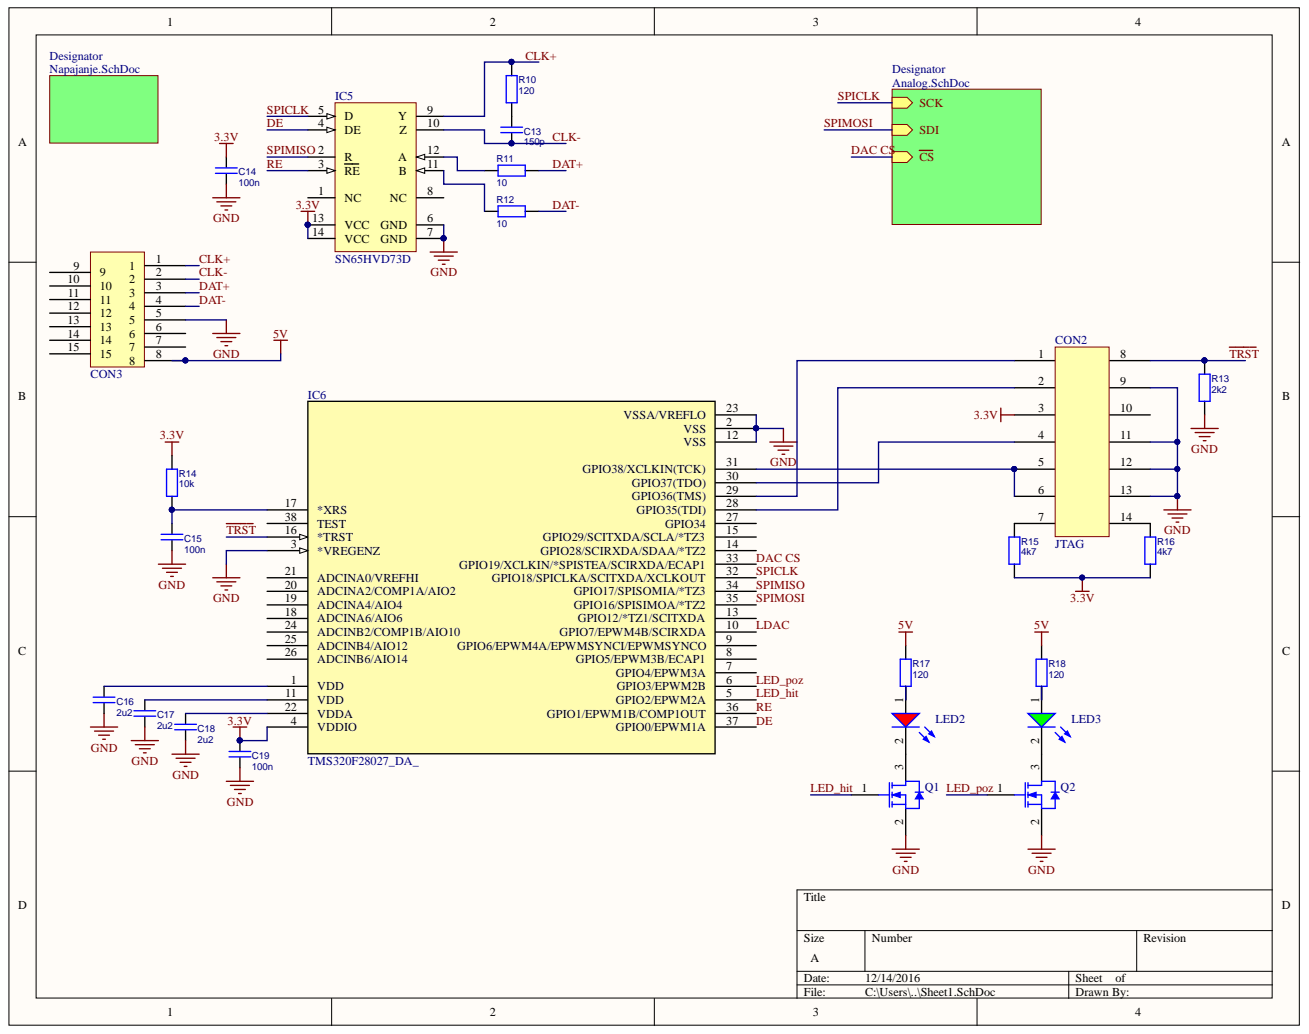
[picture p27: page 3]

GND | 5 | | 12

TEST 38

*VREGENZ 3

# Board S
