mitja1357/Seminar_iz_mehatronike/Merilnik_hitrosti/Sheet1.pdf

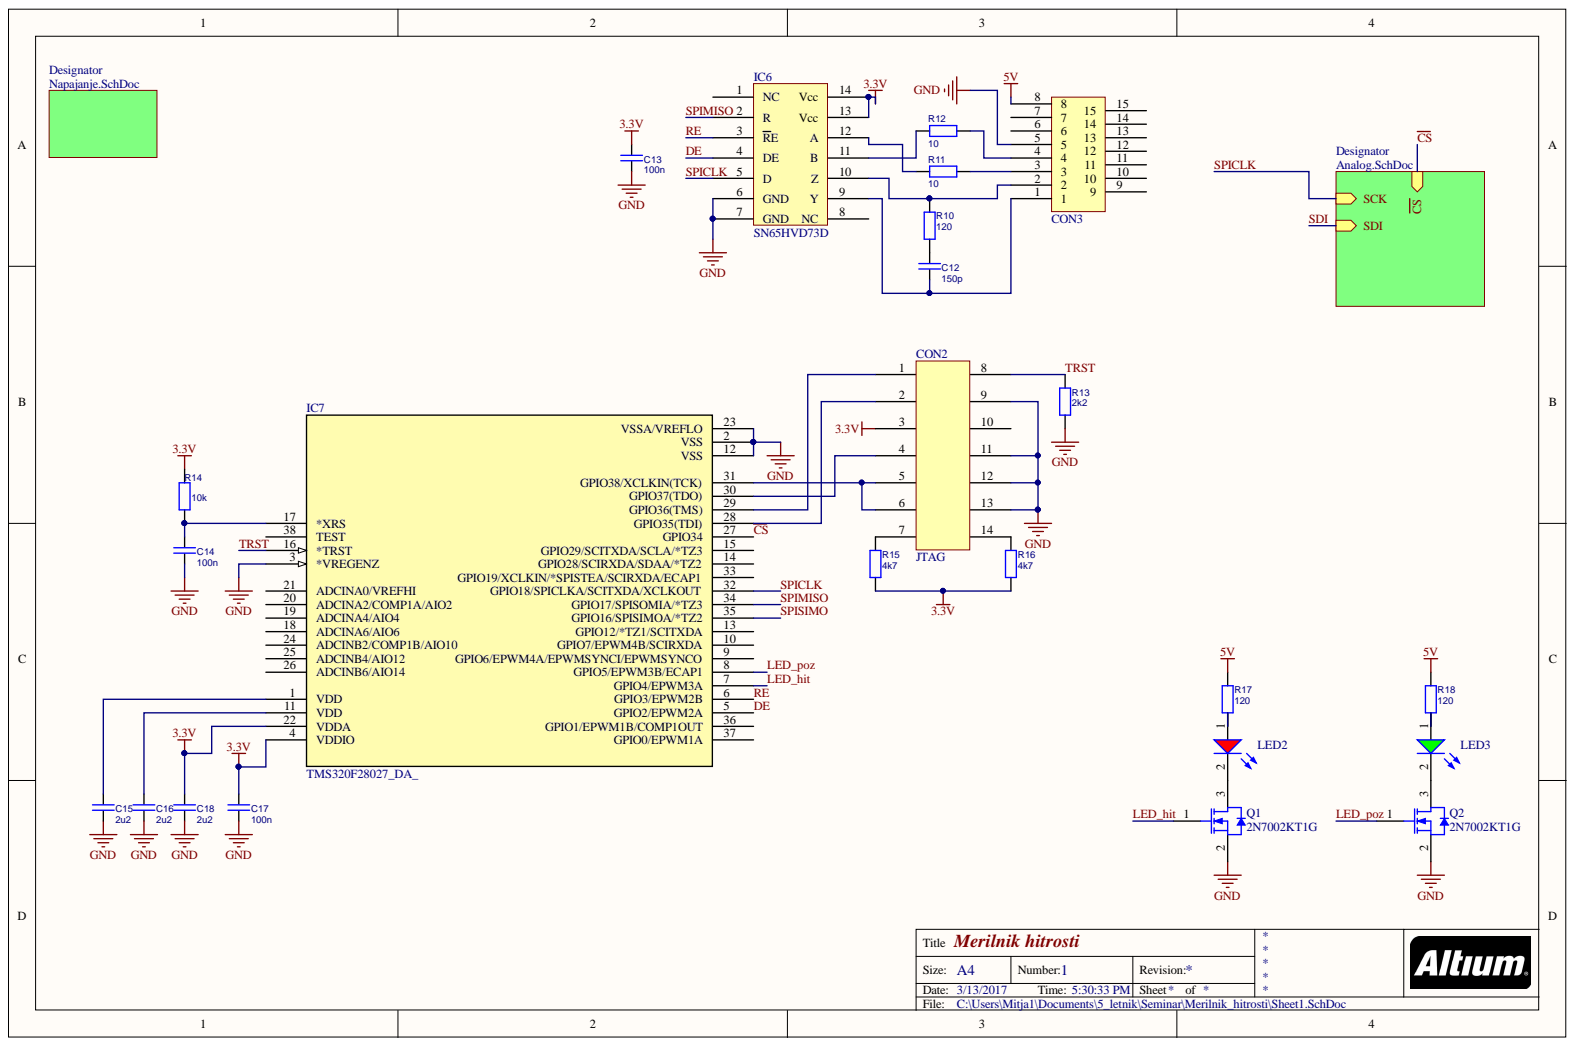
[picture p28: page 1]

Merilnik hitrosti Title | * * * * *

Size: A4 | Number: 1 | Revision: *

Date: 3/13/2017 Time: 5:30:33 PM | | Sheet * of *
File: C:\Users\Mitja1\Documents\5_letnik\Seminar\Merilnik_hitrosti\Sheet1.SchDoc

# Board S
