mitja1357/Seminar_iz_mehatronike/Merilnik_hitrosti/Sheet1_popravljena.pdf

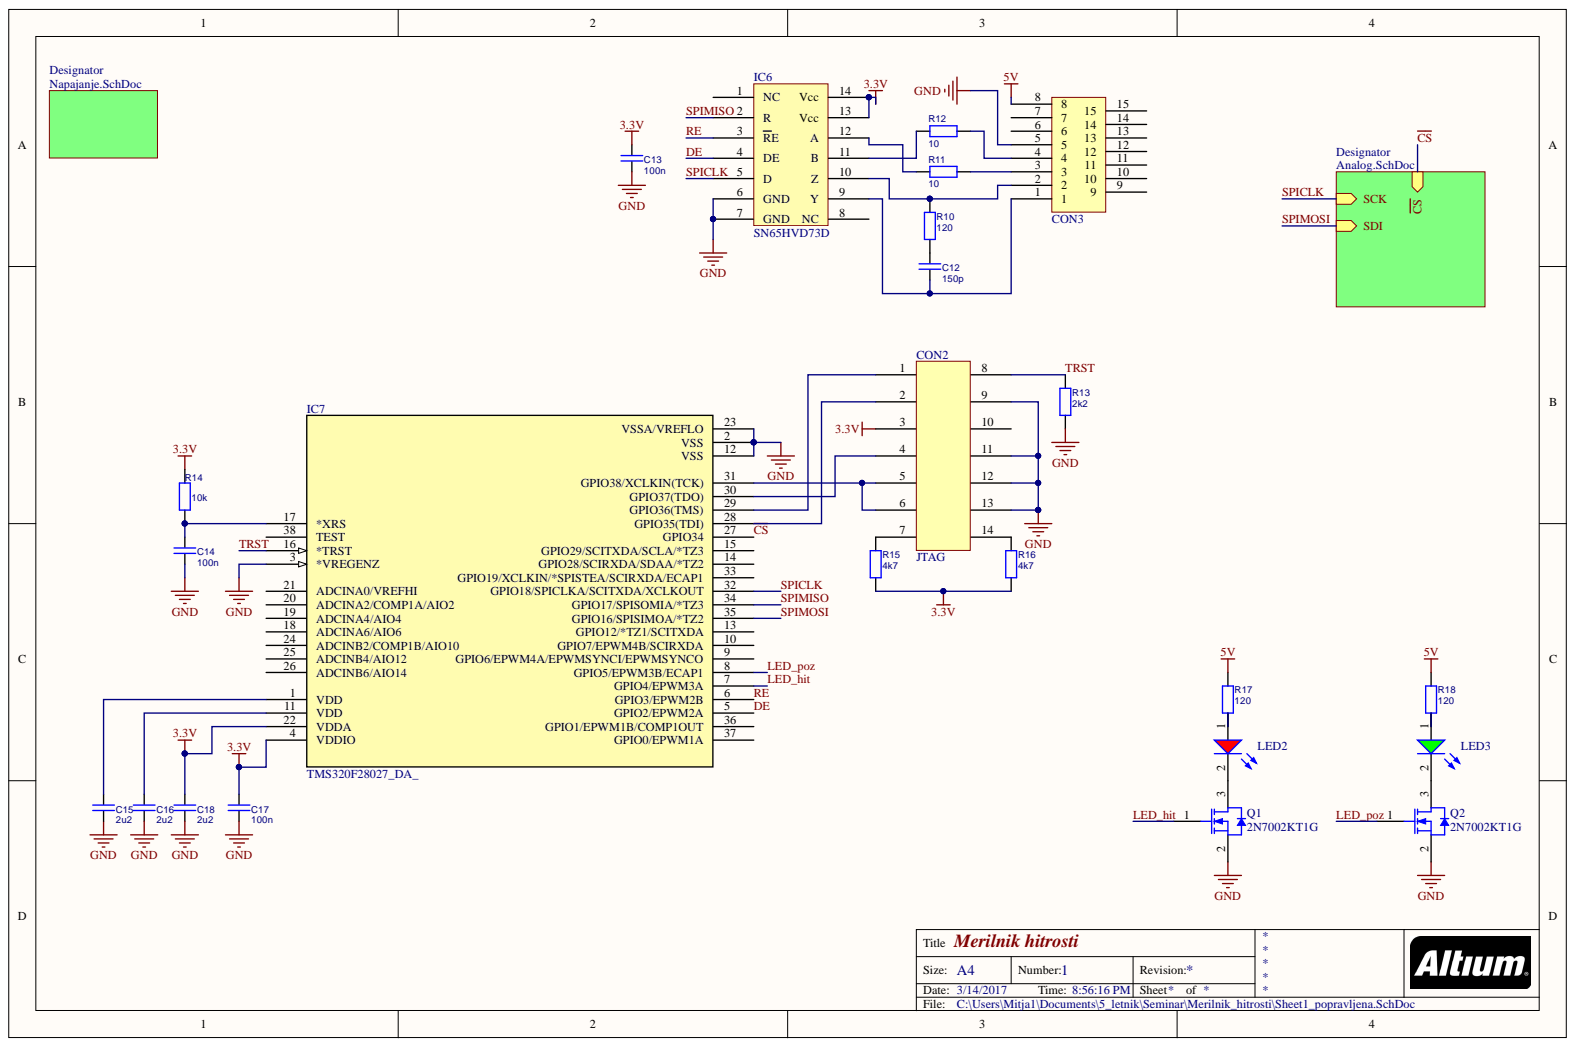
[picture p29: page 1]

Merilnik hitrosti Title | * * * * *

Size: A4 | Number: 1 | Revision: *

Date: 3/14/2017 Time: 8:56:16 PM | | Sheet * of *
File: C:\Users\Mitja1\Documents\5_letnik\Seminar\Merilnik_hitrosti\Sheet1_popravljena.SchDoc
