mitja1357/Seminar_iz_mehatronike/Porocilo/Slike/Merilnik_2017_01_13.pdf

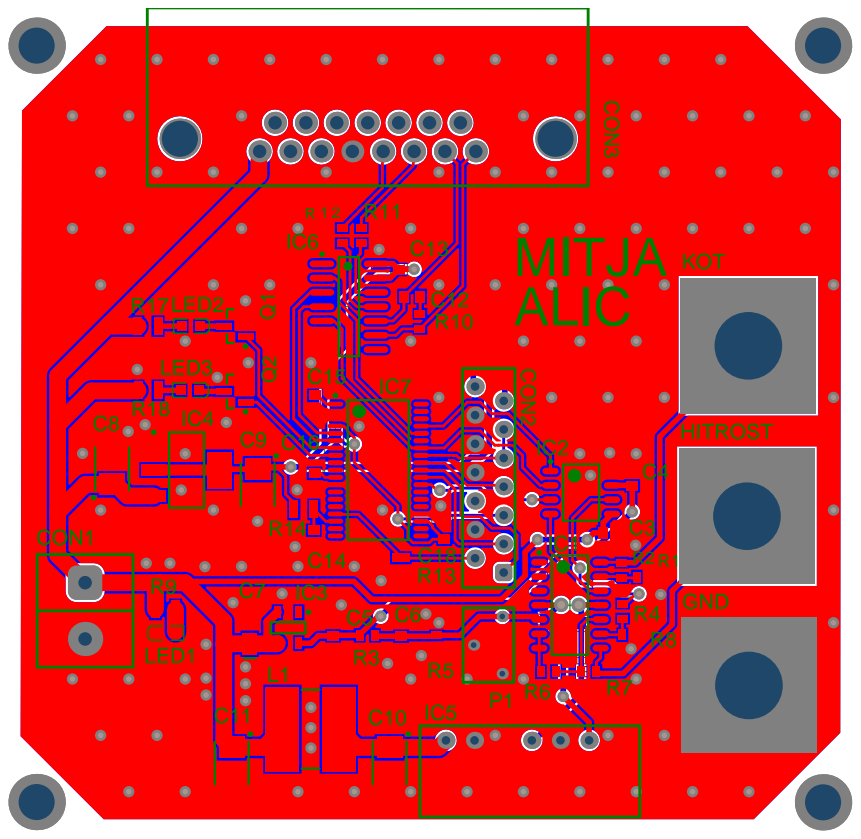
[picture p30: page 1]
