mitja1357/Seminar_iz_mehatronike/Porocilo/Slike/Merilnik_hitrosti.pdf

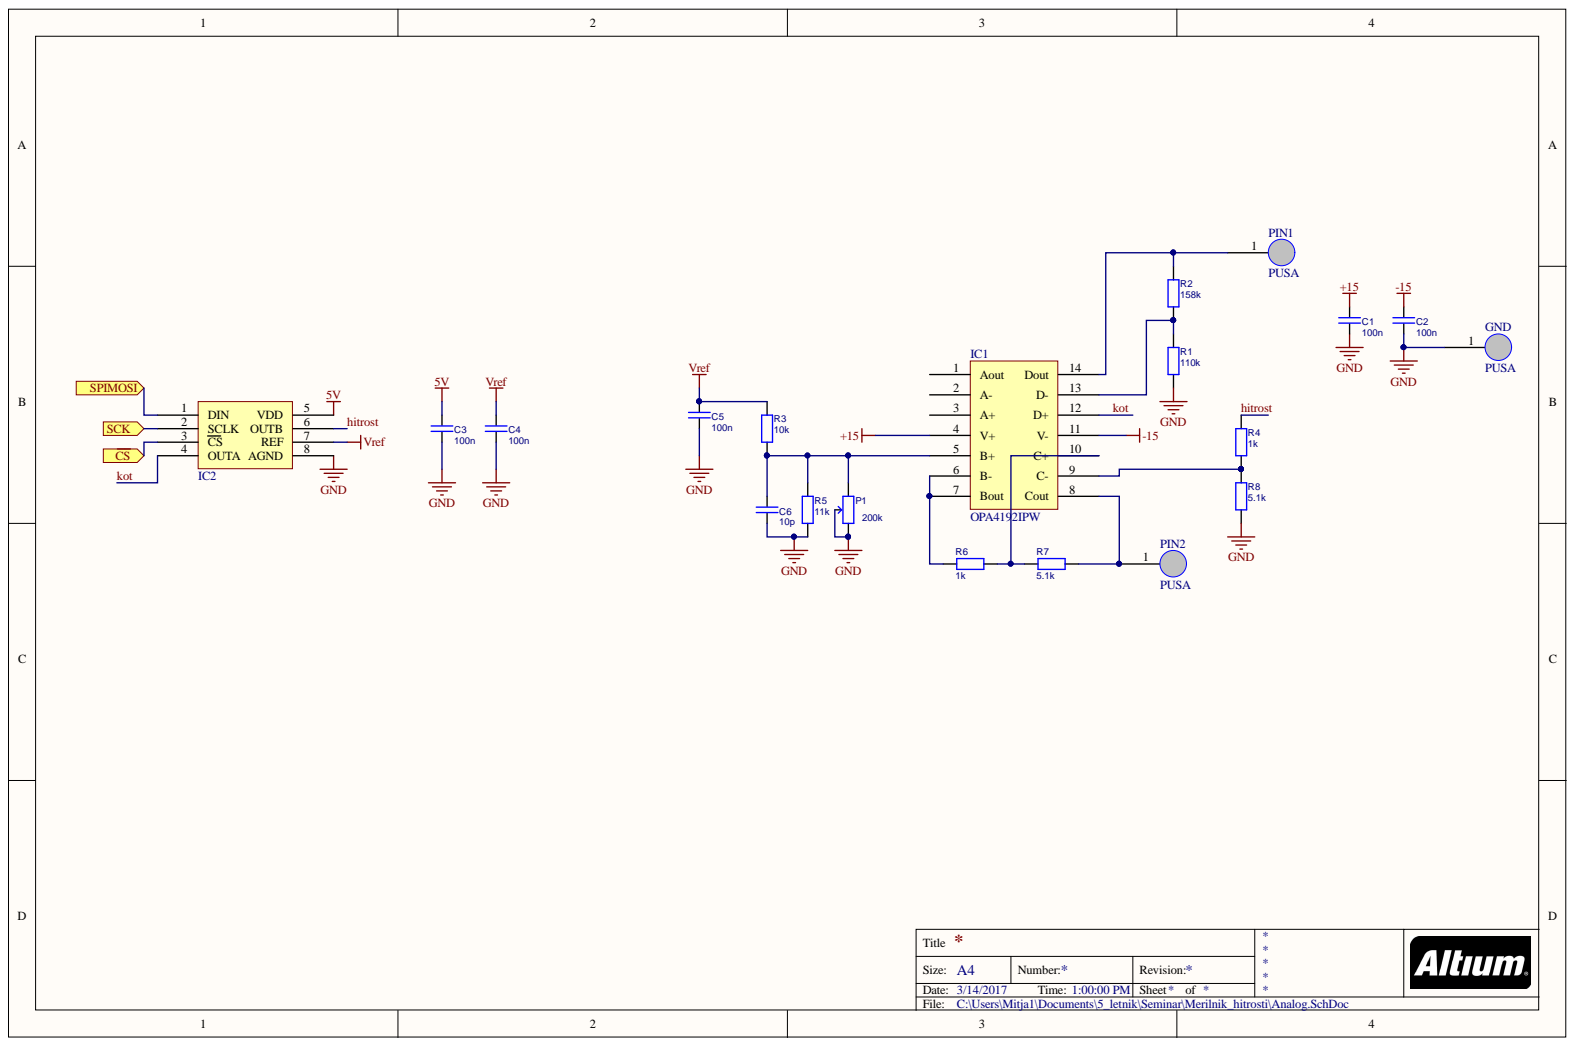
[picture p31: page 1]

A 4 | Numbe r : * | R evision: *

D ate : 3/14/2017 Time : 1:00:00 P M | | She e t * of *
File : C:\Use rs\Mitja1\Documents\5_letnik\S eminar\Me rilnik_hitrosti\Analog. S chDoc

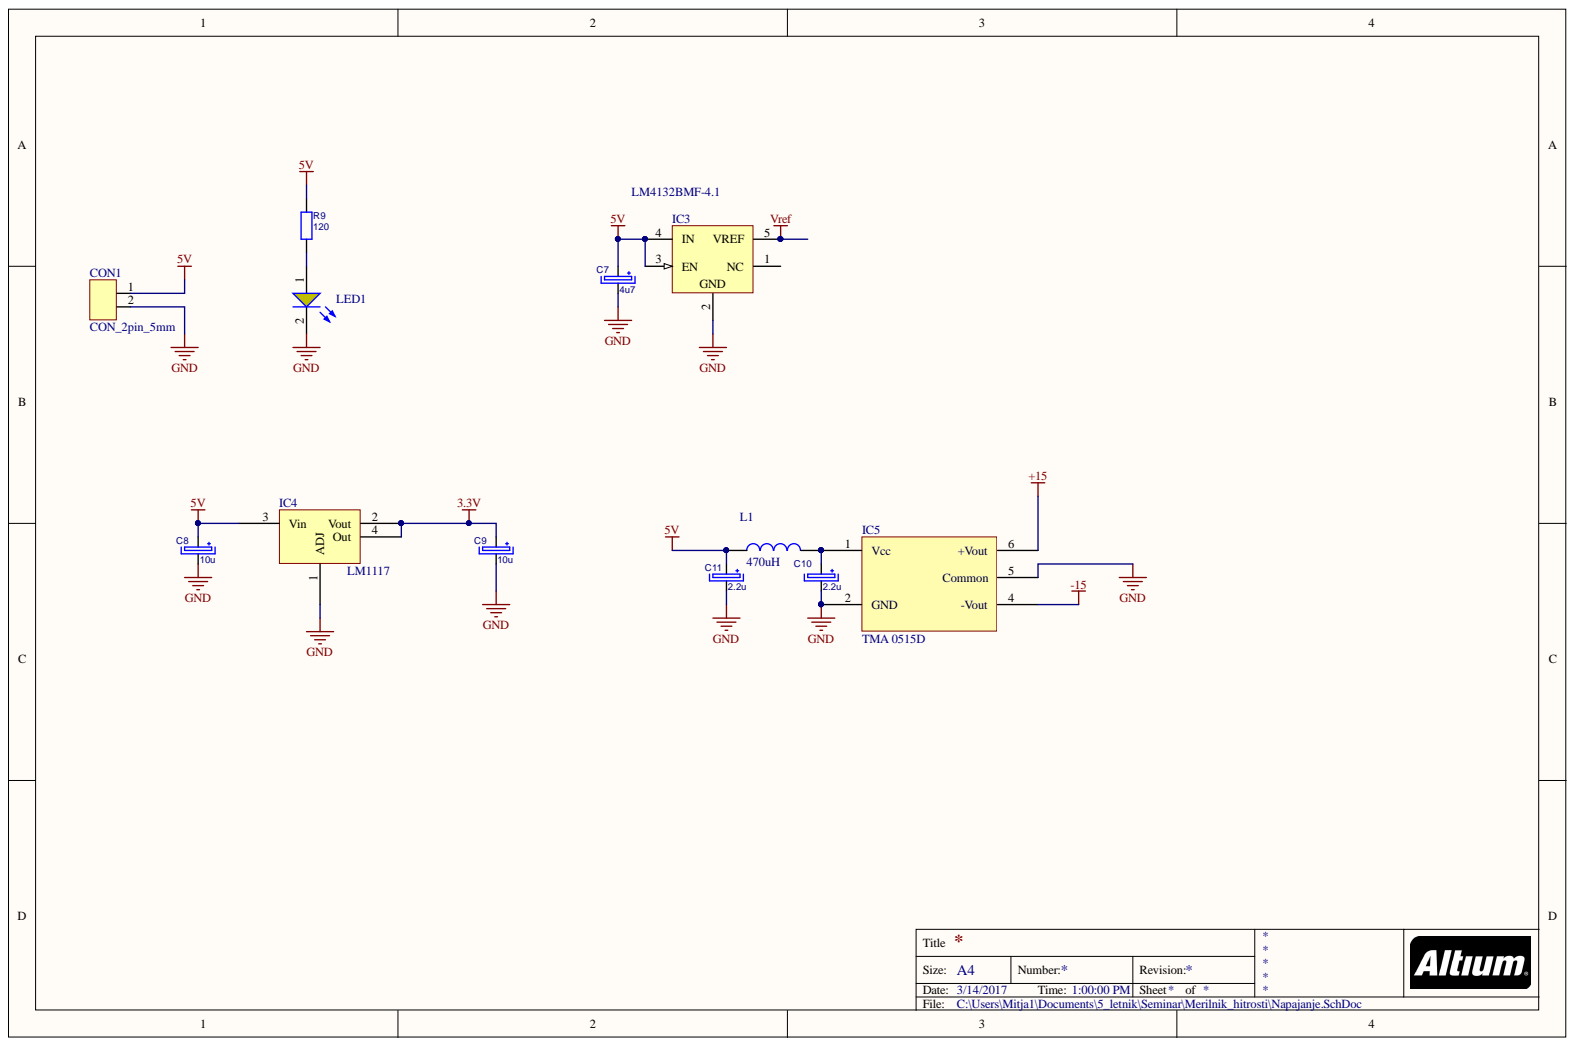
[picture p32: page 2]

* Title | * * * * *

Size: A4 | Number: * | Revision: *

Date: 3/14/2017 Time: 1:00:00 PM | | Sheet * of *
File: C:\Users\Mitja1\Documents\5_letnik\Seminar\Merilnik_hitrosti\Napajanje.SchDoc

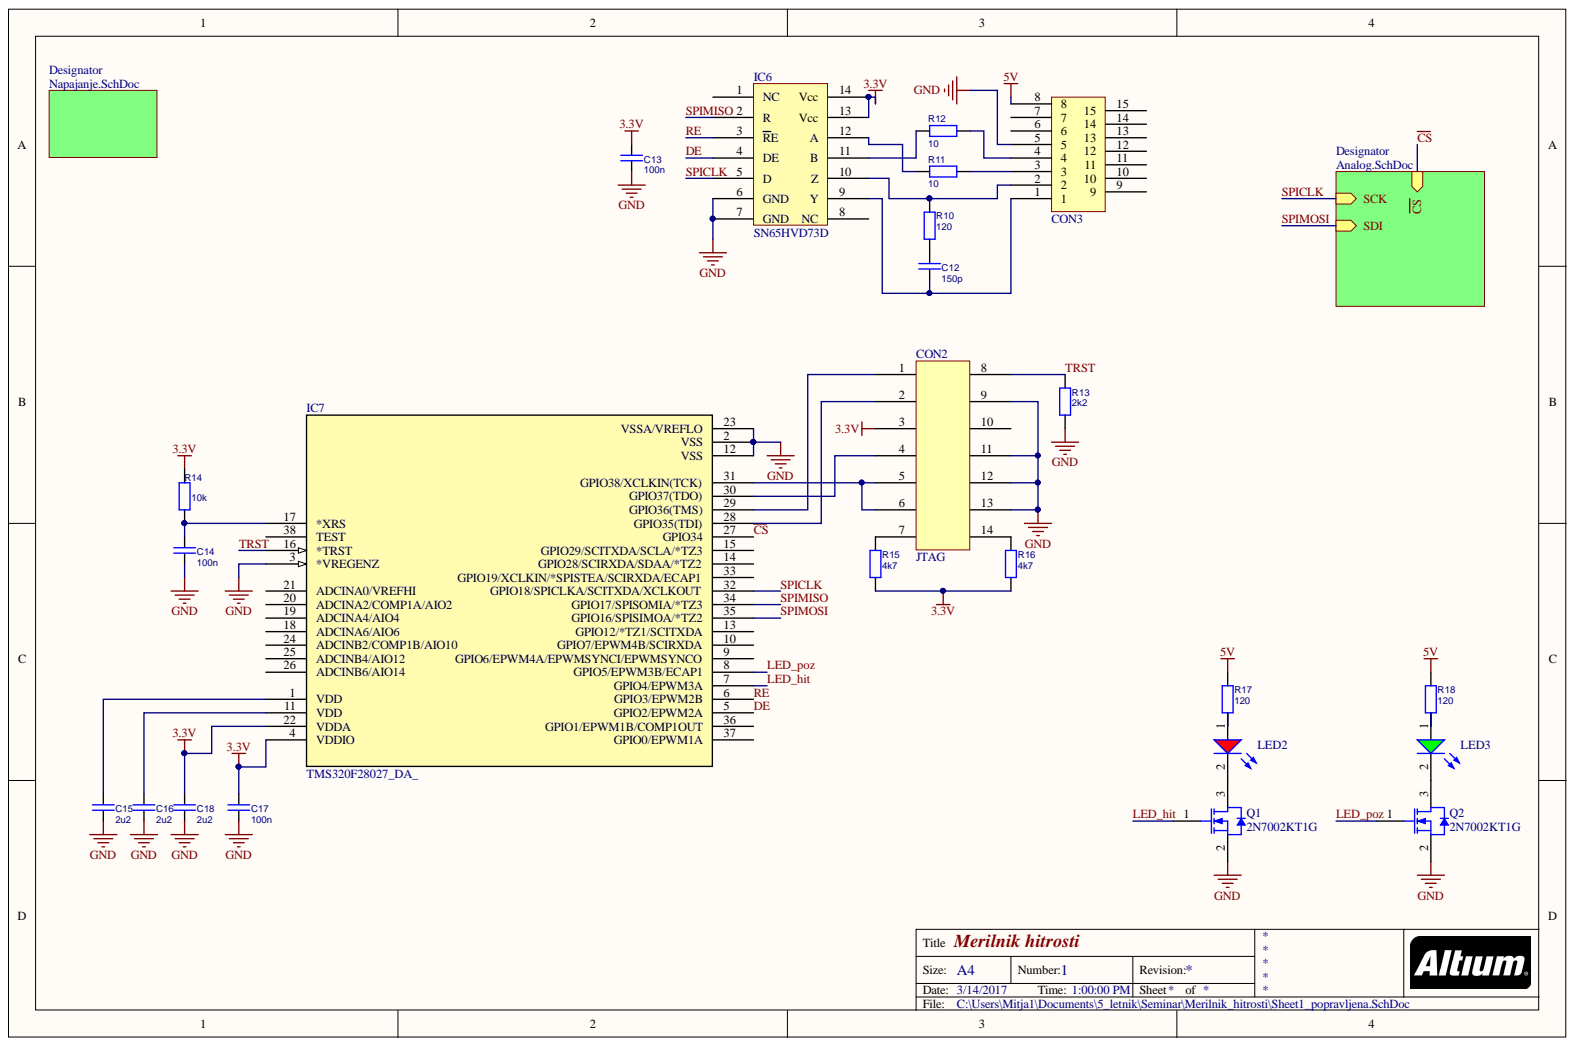
[picture p33: page 3]

Merilnik hitrosti Title | * * * * *

Size: A4 | Number: 1 | Revision: *

Date: 3/14/2017 Time: 1:00:00 PM | | Sheet * of *
File: C:\Users\Mitja1\Documents\5_letnik\Seminar\Merilnik_hitrosti\Sheet1_popravljena.SchDoc

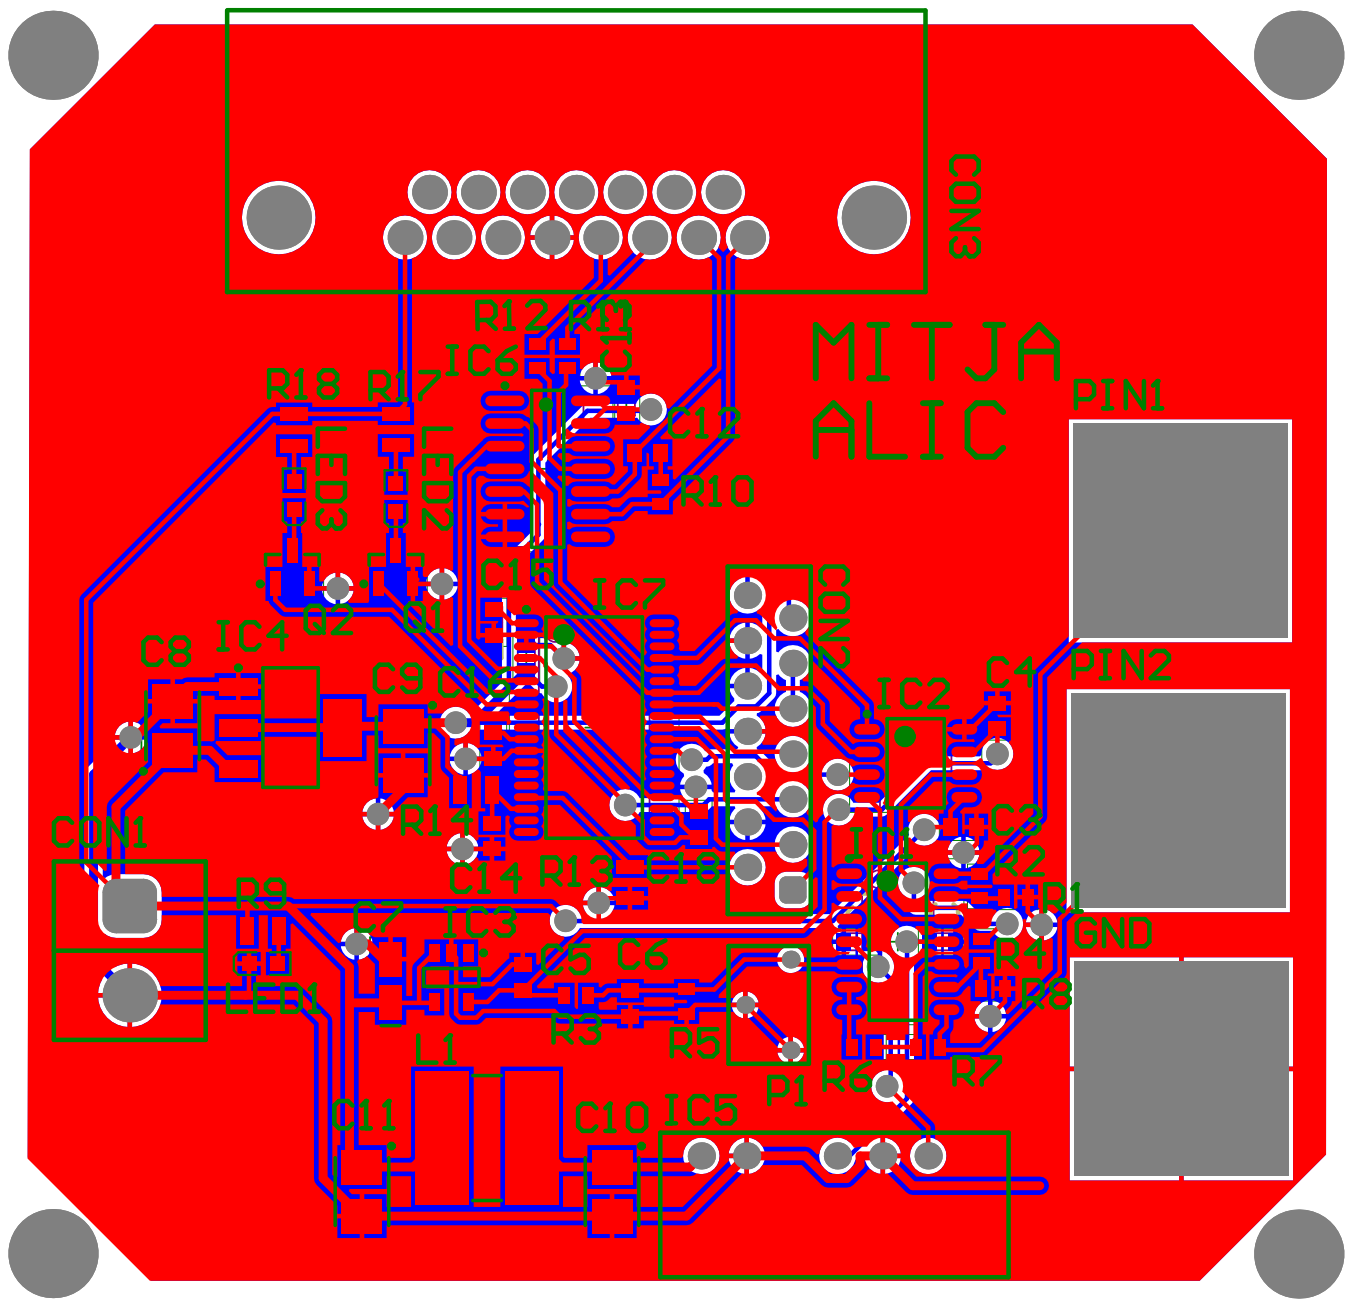
[picture p34: page 4]

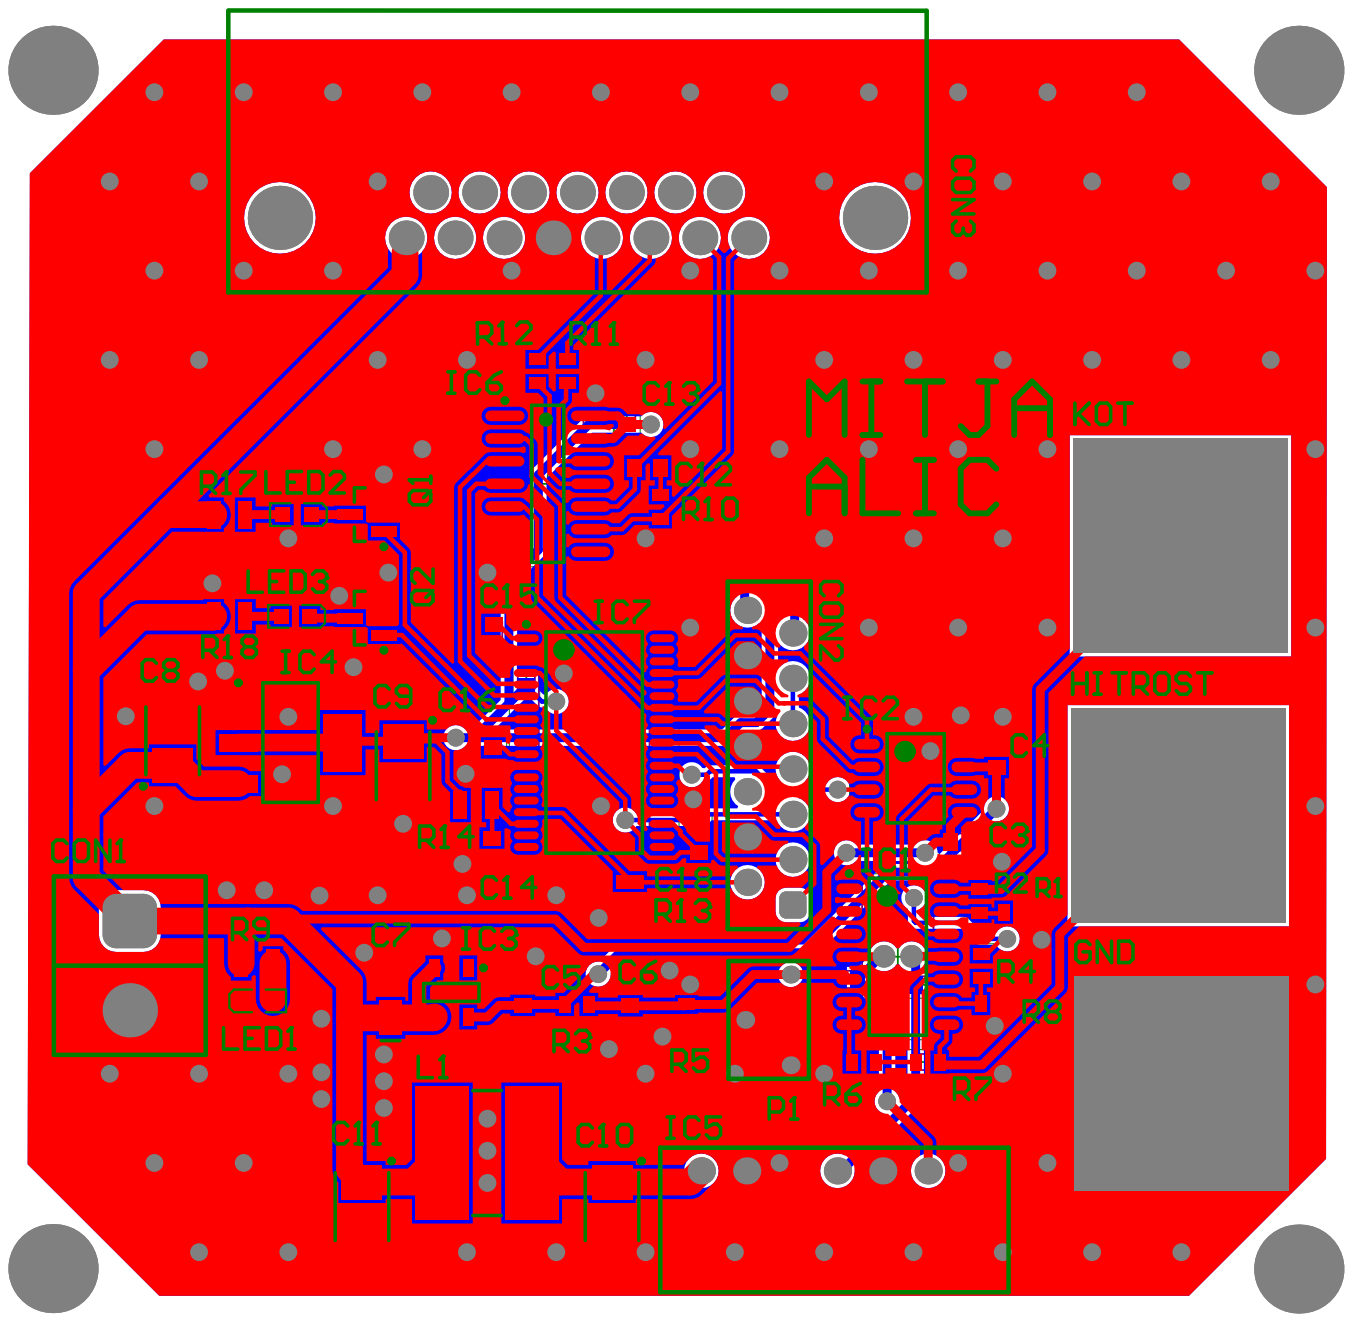
[picture p35: page 5]

# Board S
