mitja1357/Seminar_iz_mehatronike/(list of files, drawings)

Other design files:
Merilnik_hitrosti/Analog.SchDoc
Merilnik_hitrosti/Merilnik_2016_12_20.PcbDoc
Merilnik_hitrosti/Merilnik_2017_01_13.PcbDoc
Merilnik_hitrosti/Merilnik_hitrosti.PrjPcb
Merilnik_hitrosti/Napajanje.SchDoc
Merilnik_hitrosti/Sheet1.SchDoc
Merilnik_hitrosti/Sheet1_popravljena.SchDoc
